Rheinjaeger/CCD/README.md

This is the repository for CCD Small Satellite Readout System Project.
