Rheinjaeger/CCD/Design_Files/CDR(F25-13).pdf

# SwRI CCD Small Satellite Readout System (MDE F25-13)

# Actions

Task Name | Status | Assigned To | Date
Change various “Demonstration” verification types to “Test”. Whatever requires a quantifiable value is a “Test” | Complete | Jae | 4/3/2025
Define the comms protocol we’re using in requirements (from ICD) | Complete | Javier | 4/3/2025
Change “develop” to “utilize” for the comms requirement | Complete | Cody | 4/3/2025
Update Slide 10 to current design (bidirectional communication, etc.) | Complete | Cody | 4/3/2025
Remove anything from the blue box in slide 10 except for the name of our project | Complete | Cody | 4/3/2025

Task Name | Status | Assigned To | Date
Update Concept of Operations: remove shutter | Complete | Yifu | 4/3/2025
Update Concept of Operations: make “start” signal more explicit | Complete | Yifu | 4/3/2025
Update Concept of Operations: remove “image processing” | Complete | Yifu | 4/3/2025
Update Concept of Operations: don’t send signal (it’s requested async). Image is placed in a buffer | Complete | Yifu | 4/3/2025
Remove shutter from subsystem diagram | Complete | Cody | 4/3/2025
Complete Soldering Training and Lab Swipe Access | Complete | Team | 4/3/2025

# Actions

Task Name | Status | Assigned To | Date
CCD Subsystem Diagram: add how the voltage dividers will go high and low using the MOSFETs | Complete | Cody | 4/3/2025
CCD Subsystem Diagram: Complete subsystem layout for CDR | Complete | Cody | 4/3/2025
System Sequencing Diagram: add commands found in ICD | Complete | Javier | 4/3/2025
System Sequencing Diagram: add logic for “idle” and “sleep” functions | Complete | Javier | 4/3/2025
System Sequencing Diagram: change “person” icon to “spacecraft” | Complete | Yifu | 4/3/2025

# Actions

Task Name | Status | Assigned To | Date
Class Diagram: Show parameters for functions | Complete | Javier | 4/3/2025
Class Diagram: remove compression and other unnecessary blocks | Complete | Yifu | 4/3/2025
Class Diagram: expand each box with specifics for CDR | Complete | Javier | 4/3/2025
Class Diagram: change “Data Reorganization” to “Data Storage” | Complete | Yifu | 4/3/2025
Trade Studies: need to be made with later replacing with space-rated parts in mind | Complete | Cody | 4/3/2025

# Actions

Task Name | Status | Assigned To | Date
Cost Table: add estimated PCB costs to the table | Complete | Cody | 4/3/2025
Cost Table: use more of the available $500-750 budget | Complete | Cody | 4/3/2025
System Testing: choose a specific speed to test CCD at to make design easier | Complete | Jae | 4/3/2025
System Testing: no need to test with a light filter, can test with LEDs on a bench | Complete | Jae | 4/3/2025
System Testing: emulator for comms testing needs to be added to the WBS in “Testing Support” | Complete | Javier | 4/3/2025

# Actions

Task Name | Status | Assigned To | Date
System Testing: add TVAC testing to our schedule. Have a bake out schedule | Complete | Team | 4/3/2025
System Testing: make sure we know how to clean our board before entering the TVAC | Complete | Team | 4/3/2025
System Testing: get to know how our specific chamber works (constraints, how to feed wires through). Get an actual tour and as much info as possible on the TVAC chamber | Complete | Team | 4/3/2025
System Testing: add active temp readout through thermistors to the board | Complete | Cody | 4/3/2025

# Actions

Task Name | Status | Assigned To | Date
System Testing: noise testing comes before putting it in the TVAC. Short CCD connections to board ground | Complete | Javier | 4/3/2025
Project Schedule: detailed design needs to be built out for CDR | Complete | Cody | 4/3/2025
Risk Mitigation: need to find a way to mitigate almost certain risks, nothing should be in the red in terms of probability. Re-Assess risks until we have good enough procedures to reduce their probability of occurring | Complete | Jae | 4/3/2025

# Actions

Task Name | Status | Assigned To | Date
Parts Ordering: Start ordering parts that will take long shipping times. | Partially Complete | Team | 4/3/2025
Documents for the customer: Prepare a document that the team and VT isn’t responsible if the CCD is damaged | Partially Complete | Cody | 4/3/2025

# Actions

# WBS

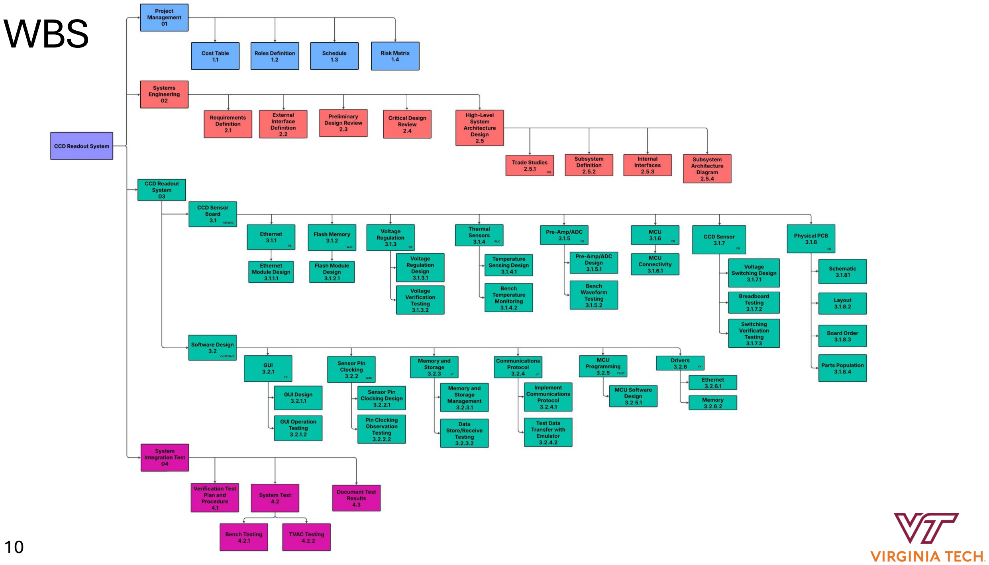
[picture p1: page 10]

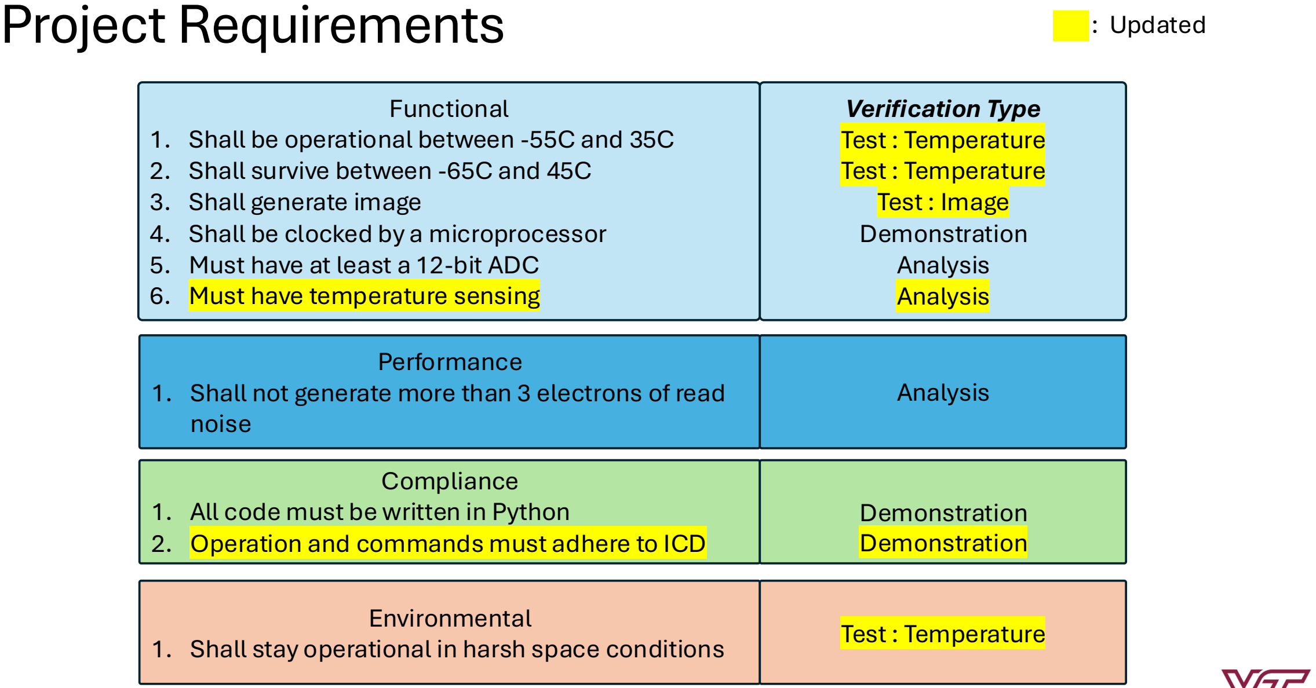
[picture p2: figure]
Project Requirements; Functional; 2. Shall survive between -65C and 45C 3. Shall generate image 4. Shall be clocked by a microprocessor 5. Must have at least a 12-bit ADC 6. Must have temperature sensing; Performance; noise; Compliance 1. All code must be written in Python; Environmental; Verification Type Test : Temperature Test : Temperature Test : Image Demonstration Analysis Analysis; Analysis; Demonstration Demonstration; Test : Temperature; : Updated

1. Shall be operational between -55C and 35C
1. Shall not generate more than 3 electrons of read
2. Operation and commands must adhere to ICD
1. Shall stay operational in harsh space conditions

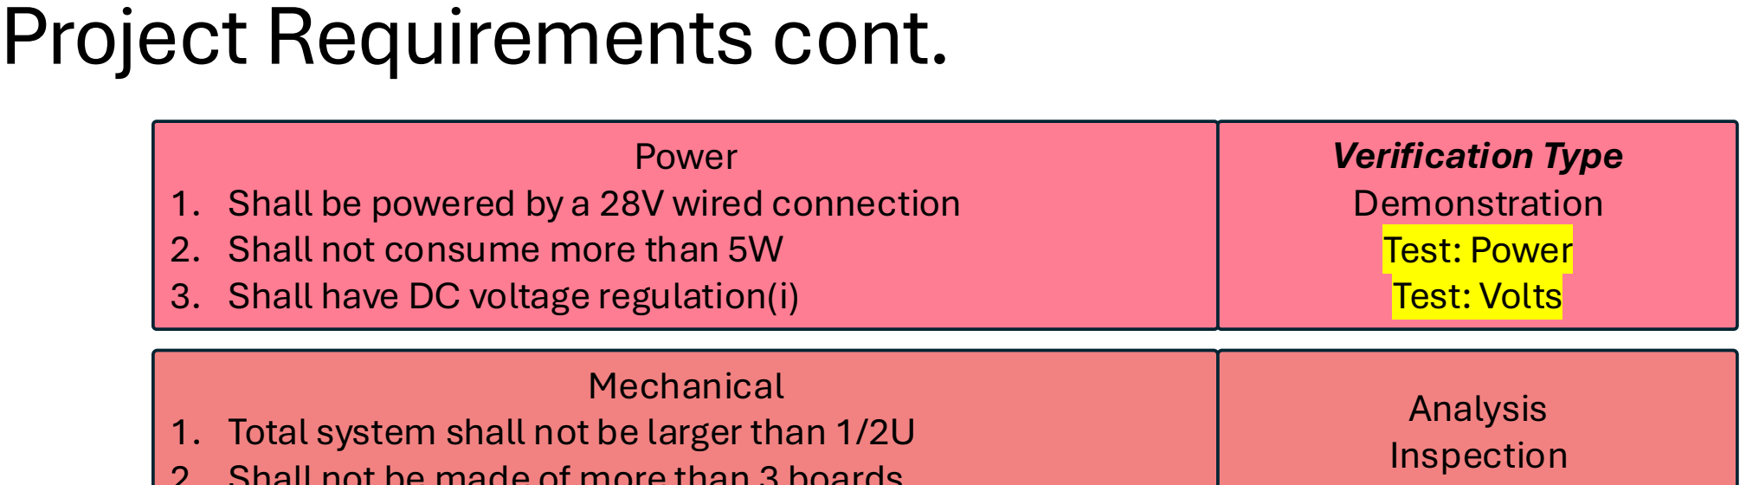
[picture p3: figure]
Power; 2. Shall not consume more than 5W 3. Shall have DC voltage regulation(i); Mechanical; Verification Type Demonstration Test: Power Test: Volts; Analysis Inspection; Project Requirements cont.

1. Shall be powered by a 28V wired connection

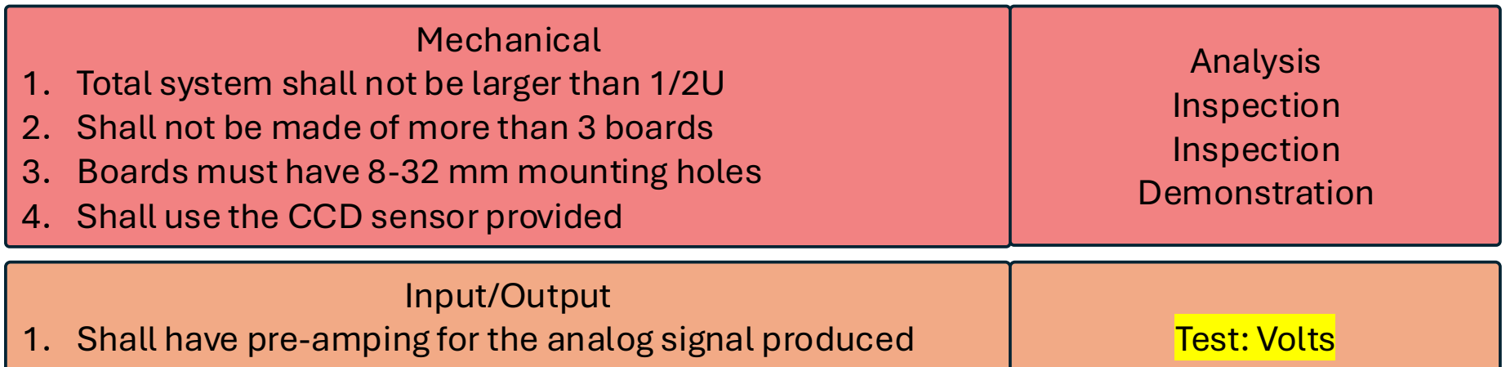
[picture p4: figure]
4. Shall use the CCD sensor provided; Input/Output; Inspection Demonstration; Test: Volts

1. Total system shall not be larger than 1/2U
2. Shall not be made of more than 3 boards
3. Boards must have 8-32 mm mounting holes

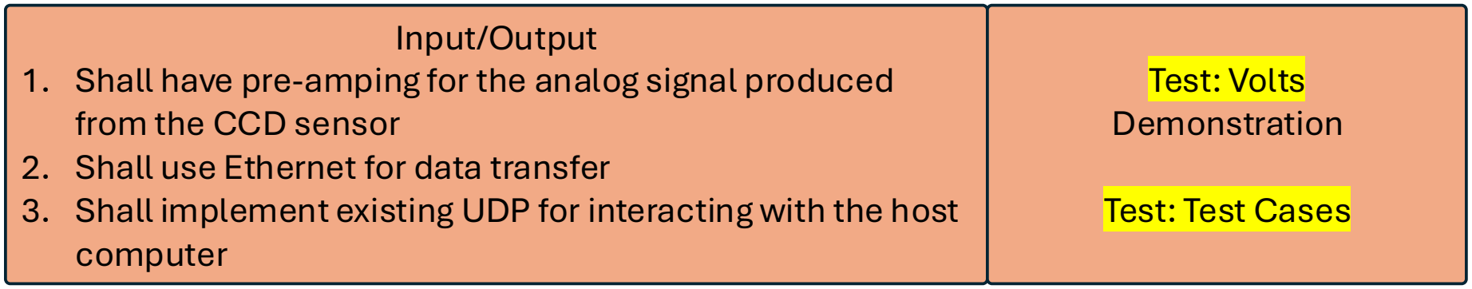
[picture p5: figure]
from the CCD sensor 2. Shall use Ethernet for data transfer; computer; Demonstration; Test: Test Cases

1. Shall have pre-amping for the analog signal produced
3. Shall implement existing UDP for interacting with the host

i: Voltage biasing for 29V, 25V, 17V, 12V, 10V, 9.5 V, 3.3V, 3V

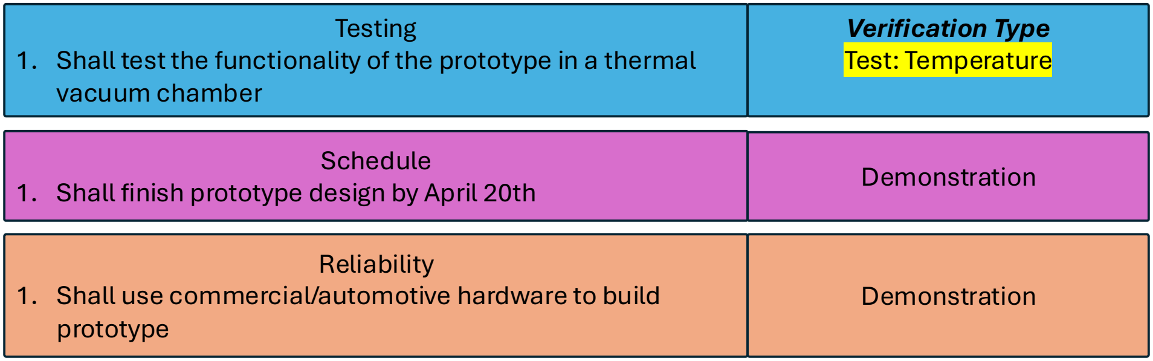
[picture p6: figure]
Testing; vacuum chamber; Schedule; Verification Type Test: Temperature; Demonstration; Reliability; prototype

1. Shall test the functionality of the prototype in a thermal
1. Shall finish prototype design by April 20th

## Nice to Have

1. Should use a 16-bit ADC (as opposed to 12-bit) | Demonstration
1. Shall use commercial/automotive hardware to build

Project Requirements cont.

# CCD Sensor System Diagram

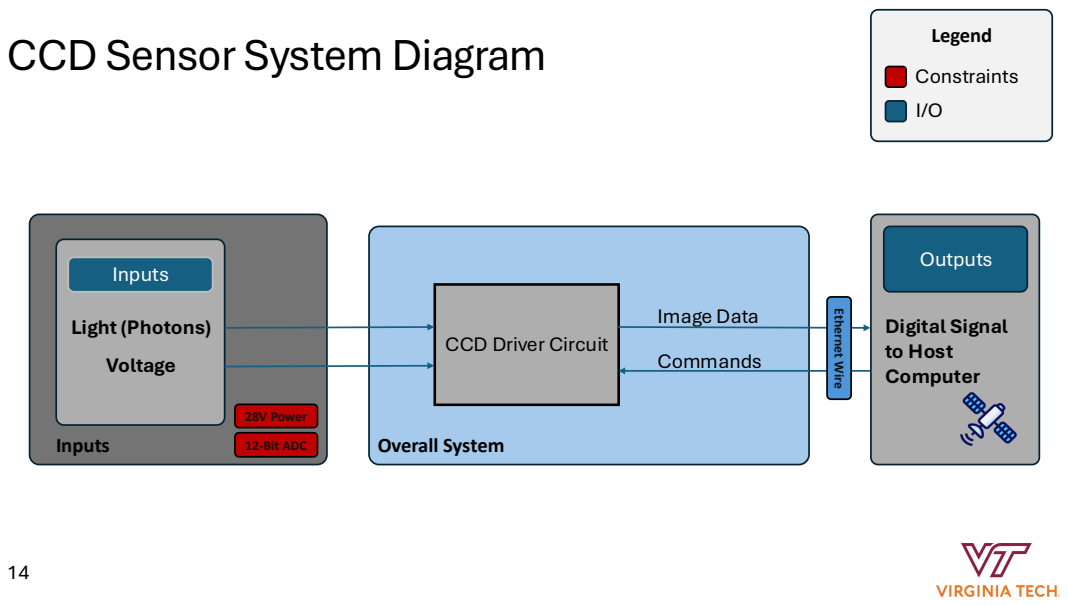
[picture p7: page 14]
Outputs; Digital Signal to Host Computer; Image Data; Overall System; Inputs; Light (Photons); Voltage; 12-Bit ADC; 28V Power; Legend Constraints I/O; Commands; Ethernet Wire

CCD Driver Circuit

# Concepts of Operations

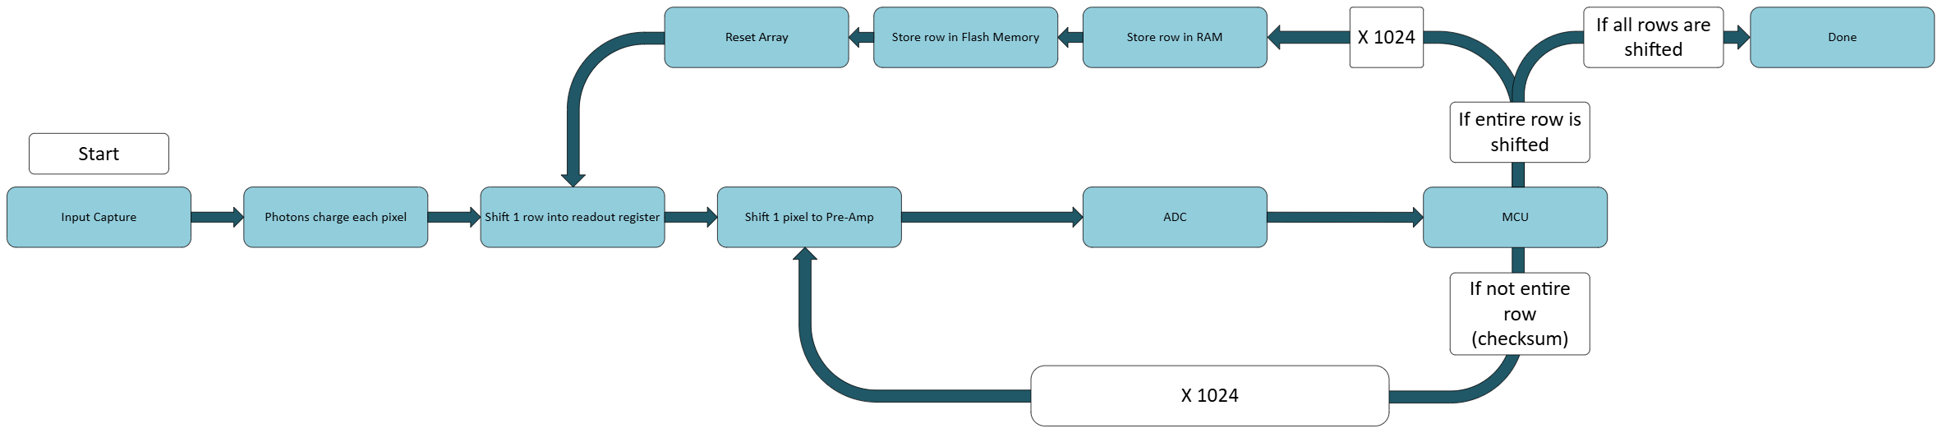
[picture p8: figure]

# Hardware Subsystems

# CCD Subsystem Diagram

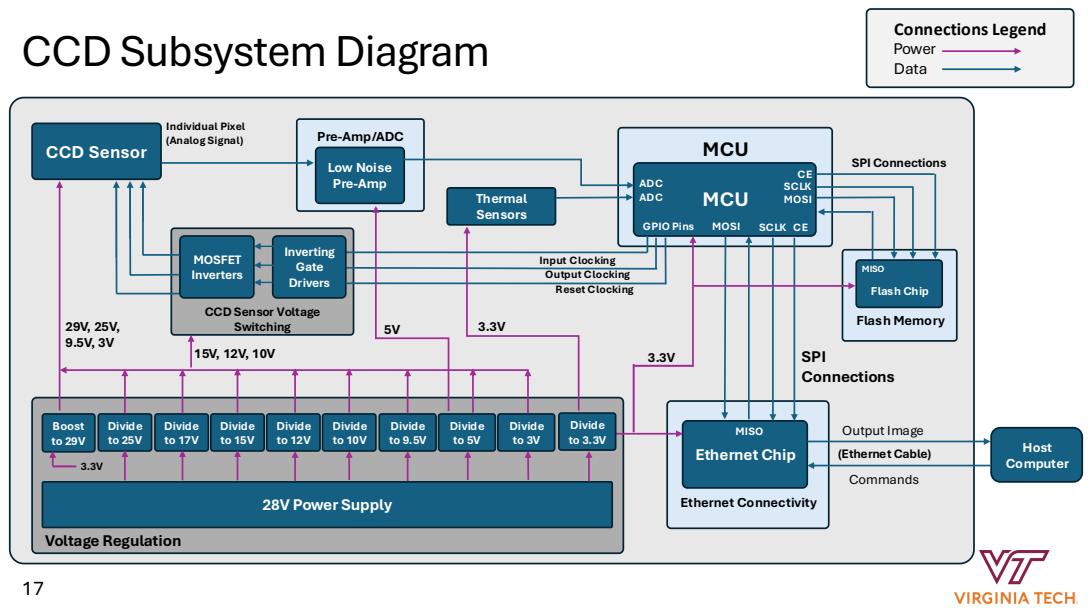
[picture p9: page 17]
Flash Memory; MCU; Flash Chip; CCD Sensor Voltage Switching; Ethernet Connectivity; Ethernet Chip; 28V Power Supply; Divide to 9.5V; Boost to 29V; MISO; Output Image; MOSI; ADC; SCLK CE; Connections Legend Power Data; Host Computer; Divide to 25V; Divide to 17V; Divide to 15V; Divide to 12V; Divide to 10V; Commands; SPI Connections; GPIO Pins; Input Clocking Output Clocking Reset Clocking; Individual Pixel (Analog Signal); (Ethernet Cable); MOSFET Inverters; CE SCLK MOSI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

Pre-Amp/ADC
Low Noise
Pre-Amp

# PCB Schematics and Simulations

# PCB Schematic: MCU, Preamp, and Memory

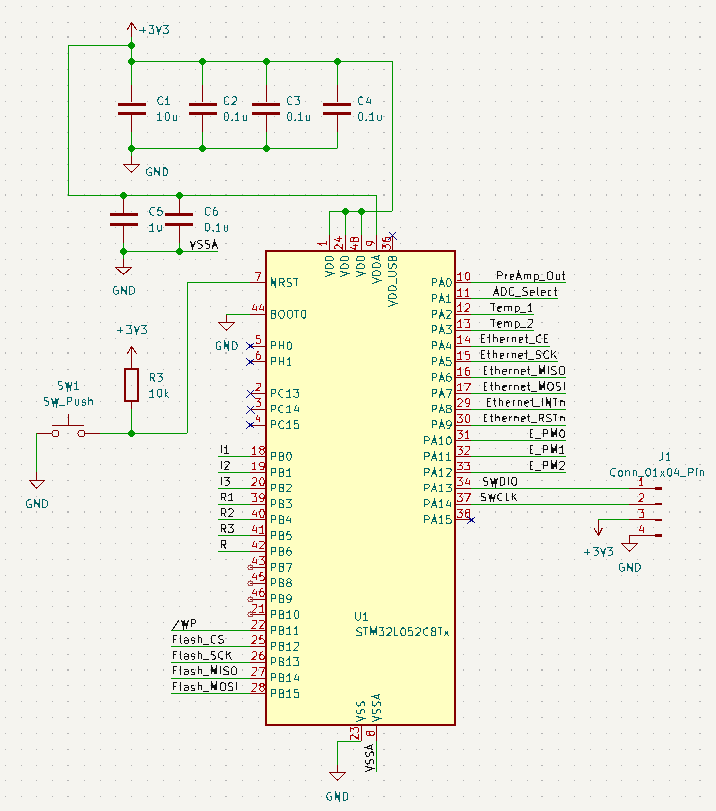
[picture p10: figure]

Labeled Connections to:
- Pre-Amp
- Temperature Sensors 1 and 2
- Ethernet Module (W5500)
- SWD Debug Pins
- Flash Memory Chip
- Gate Driver Inputs

Other Connections:
- VDD and decoupling capacitors
- Push Button with a Pull-Up Resistor for Reset
- Boot0 pulled low for normal booting

# PCB Schematic: Preamp and Flash Memory

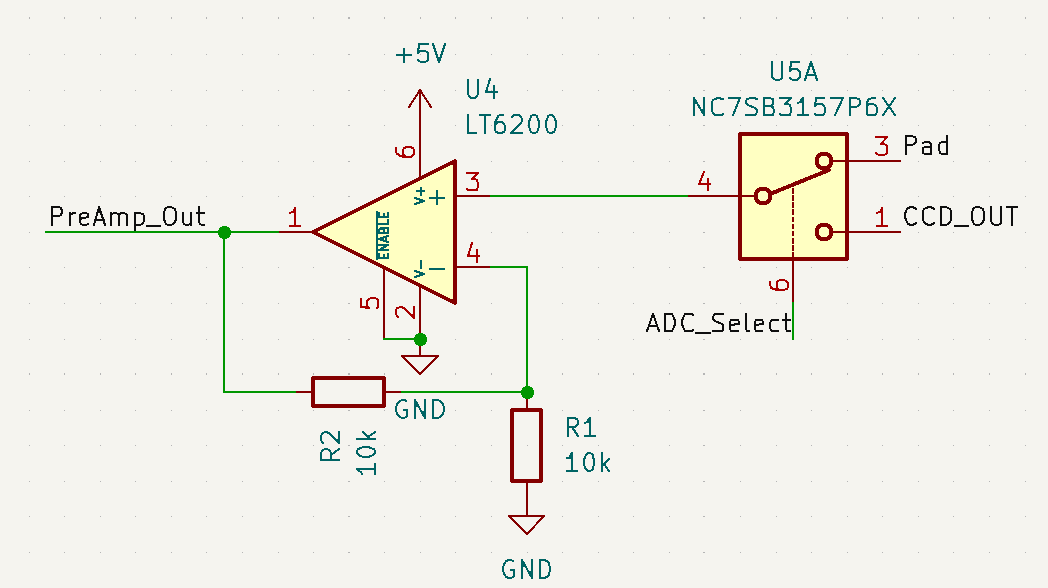
[picture p11: figure]

- Amplifier with a Gain of 2
- Positive input is connected to a 2x1 MUX, which is connected to a pad, and the CCD output
- The select pin for the MUX is connected to a GPIO pin on the MCU

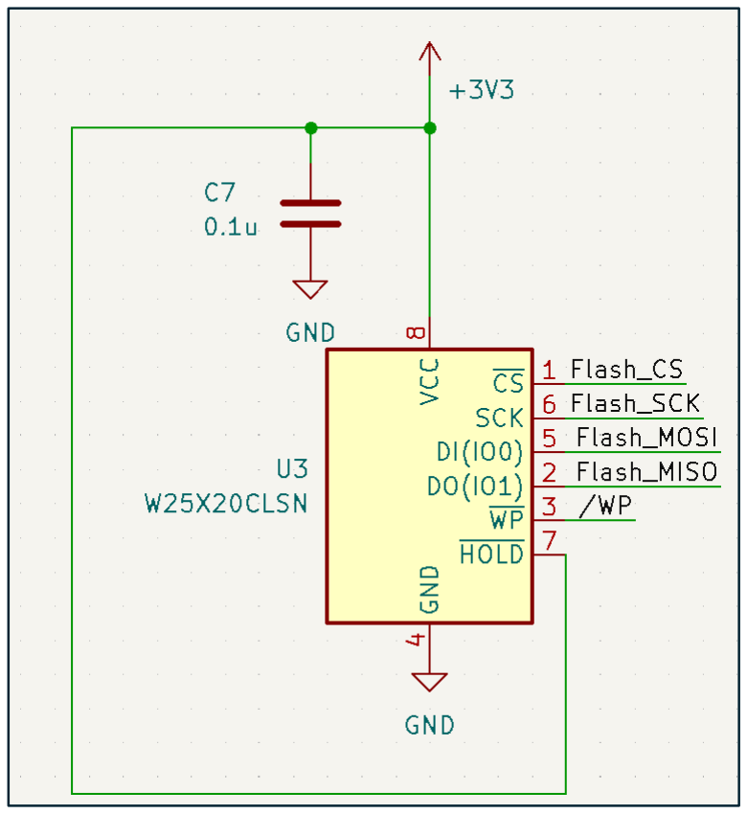
[picture p12: figure]

- 1Gbit Flash Memory
- Pins connected to the second SPI channel on the MCU

# PCB Schematic: Power Regulation (Voltage Dividers)

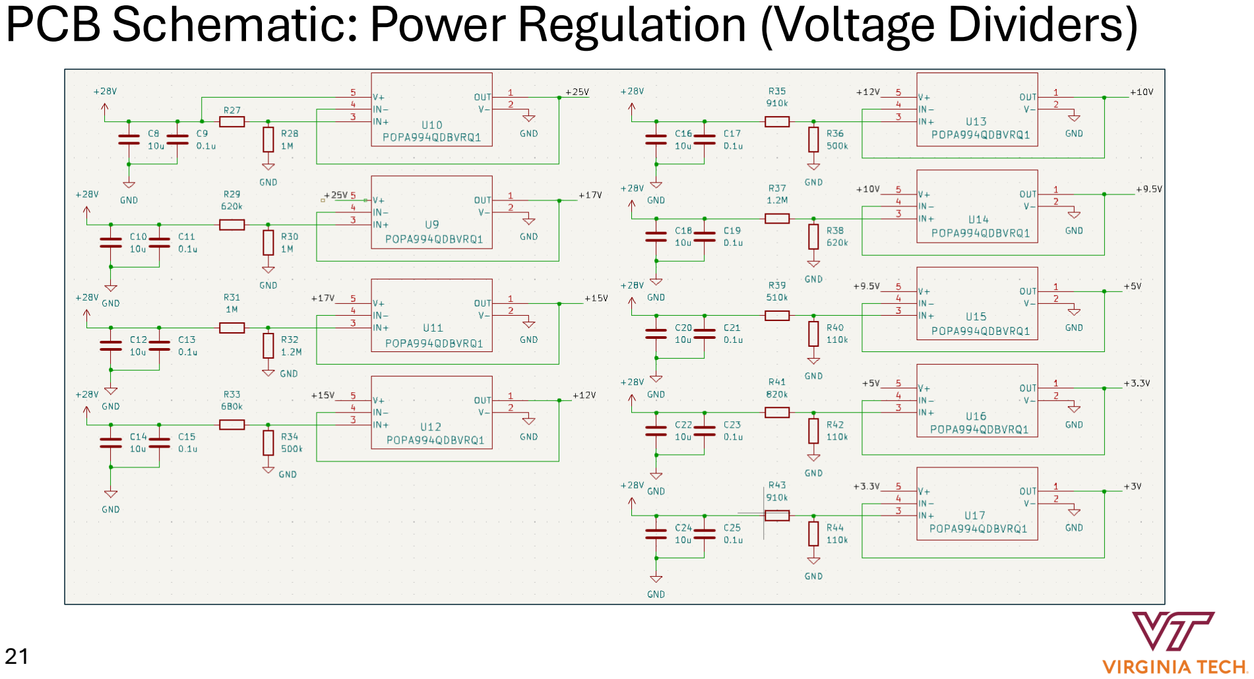
[picture p13: page 21]

# Hardware Simulation: Voltage Dividers

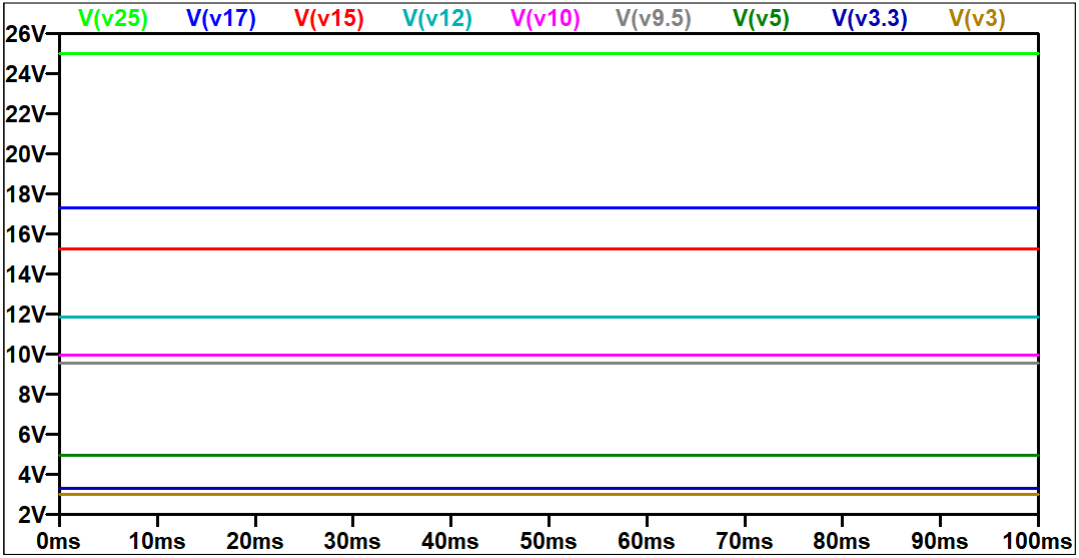
[picture p14: figure]

# PCB Schematic: Power Regulation (Boost Converter)

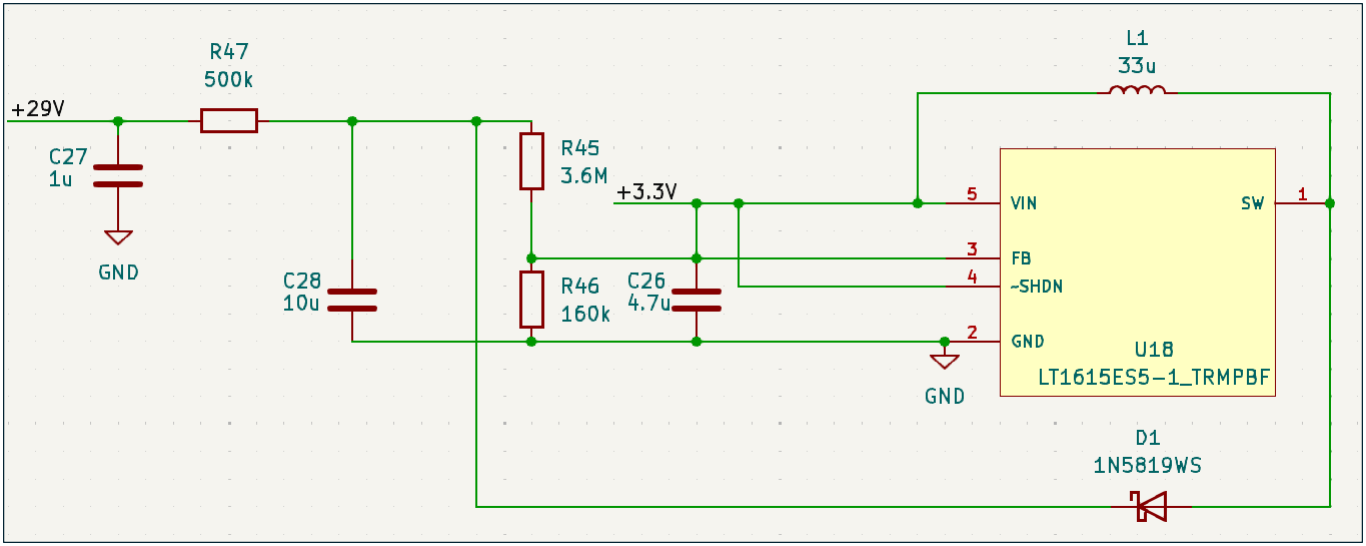
[picture p15: figure]

# Hardware Simulation: Boost Converter to 29V

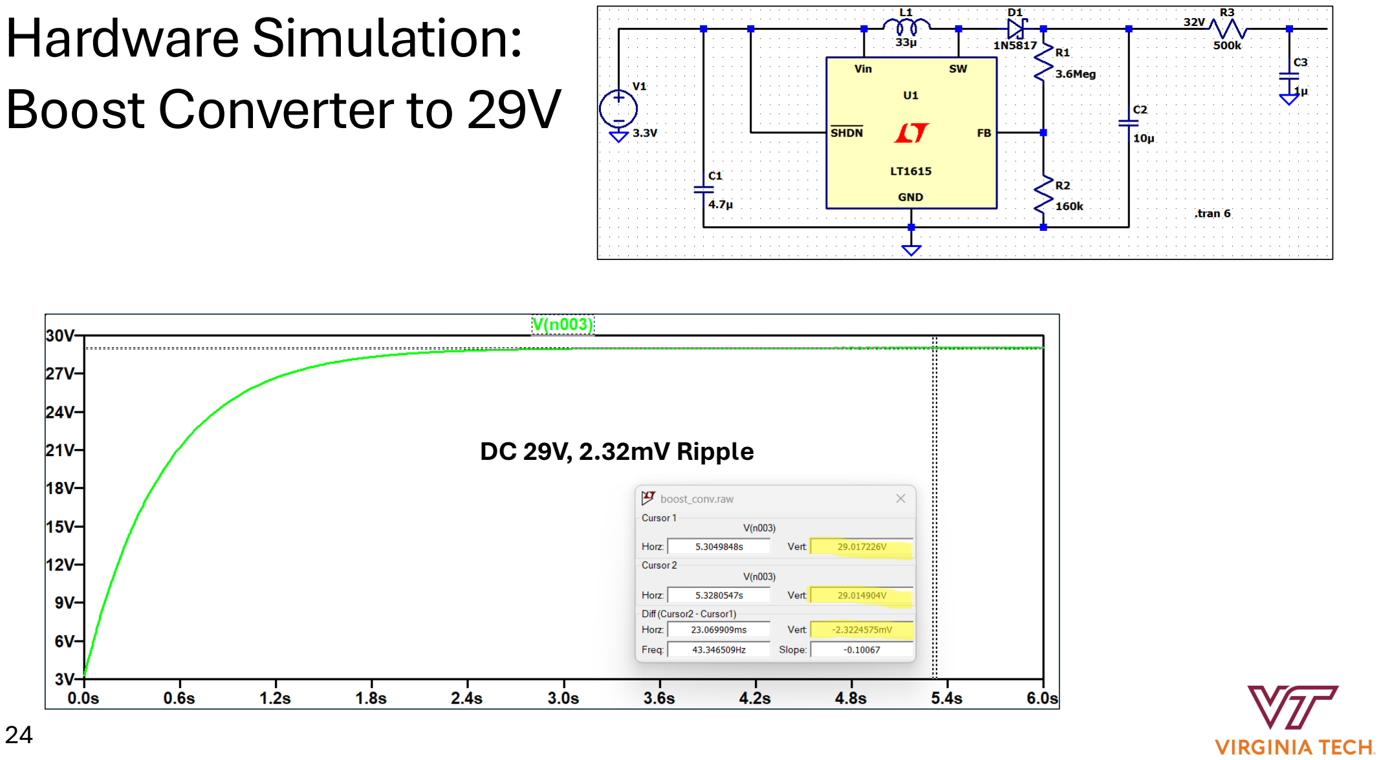
[picture p16: page 24]

DC 29V, 2.32mV Ripple

# PCB Schematic: MOSFET Switching (One Switch)

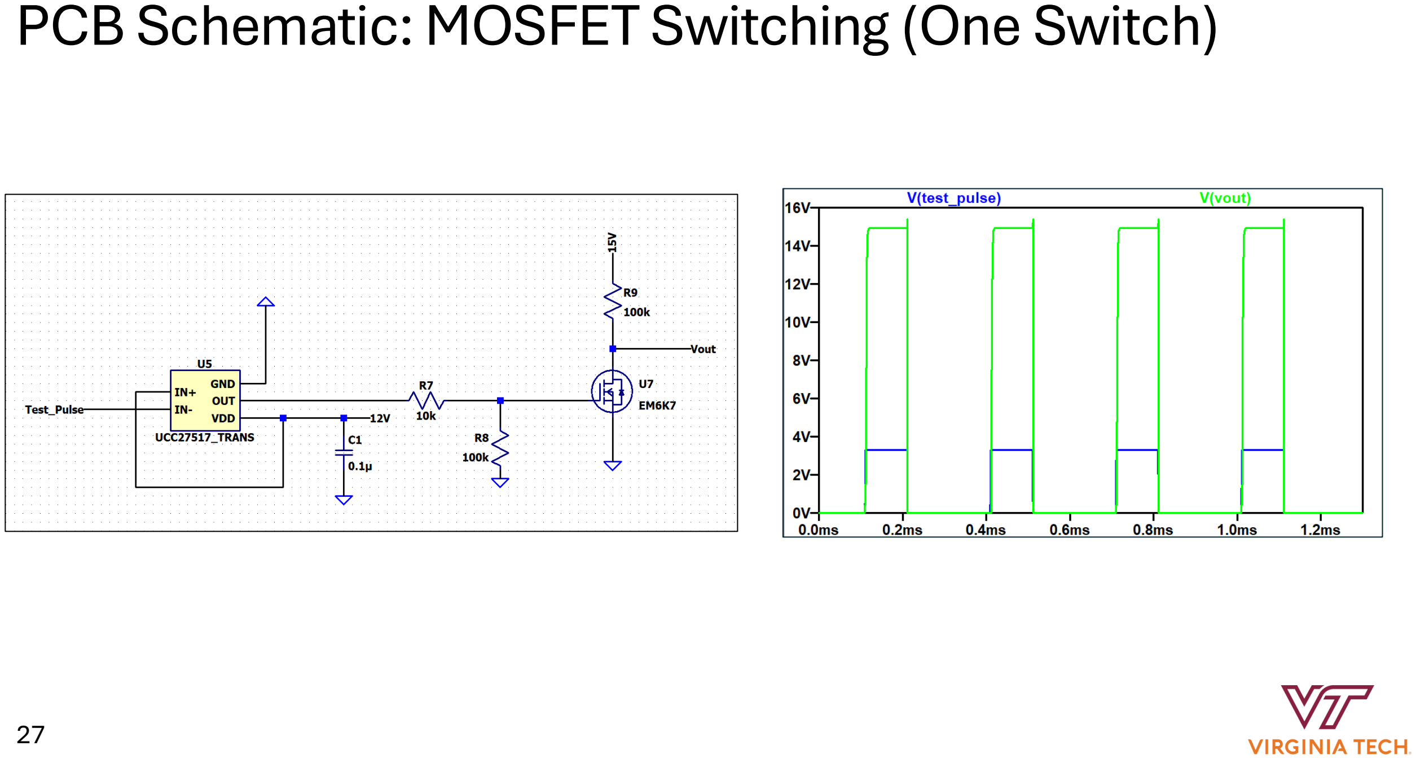
[picture p17: page 25]

# PCB Schematic: MOSFET Switching (Section 1)

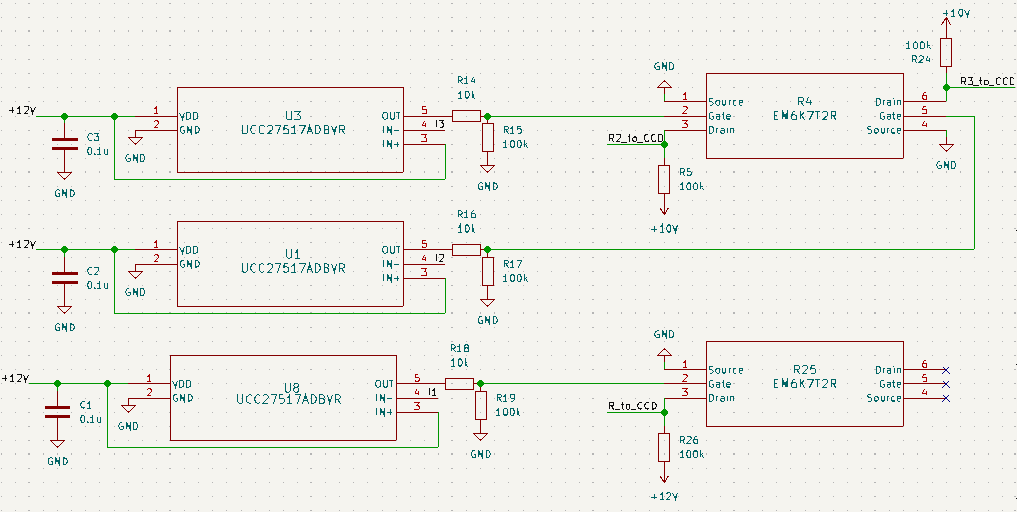
[picture p18: figure]

# PCB Schematic: MOSFET Switching (Section 2)

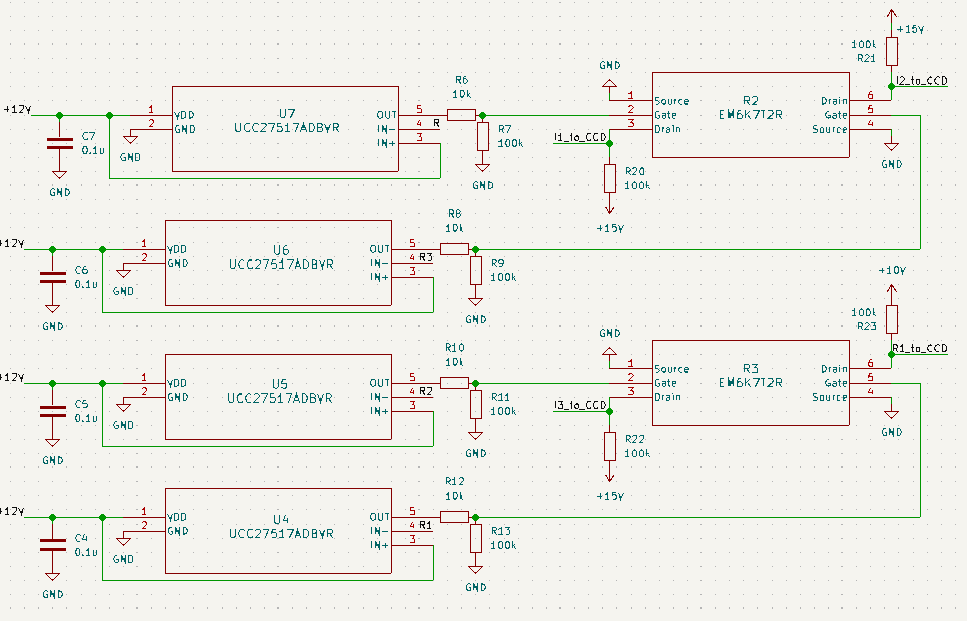
[picture p19: figure]

# PCB Schematic: Ethernet Module

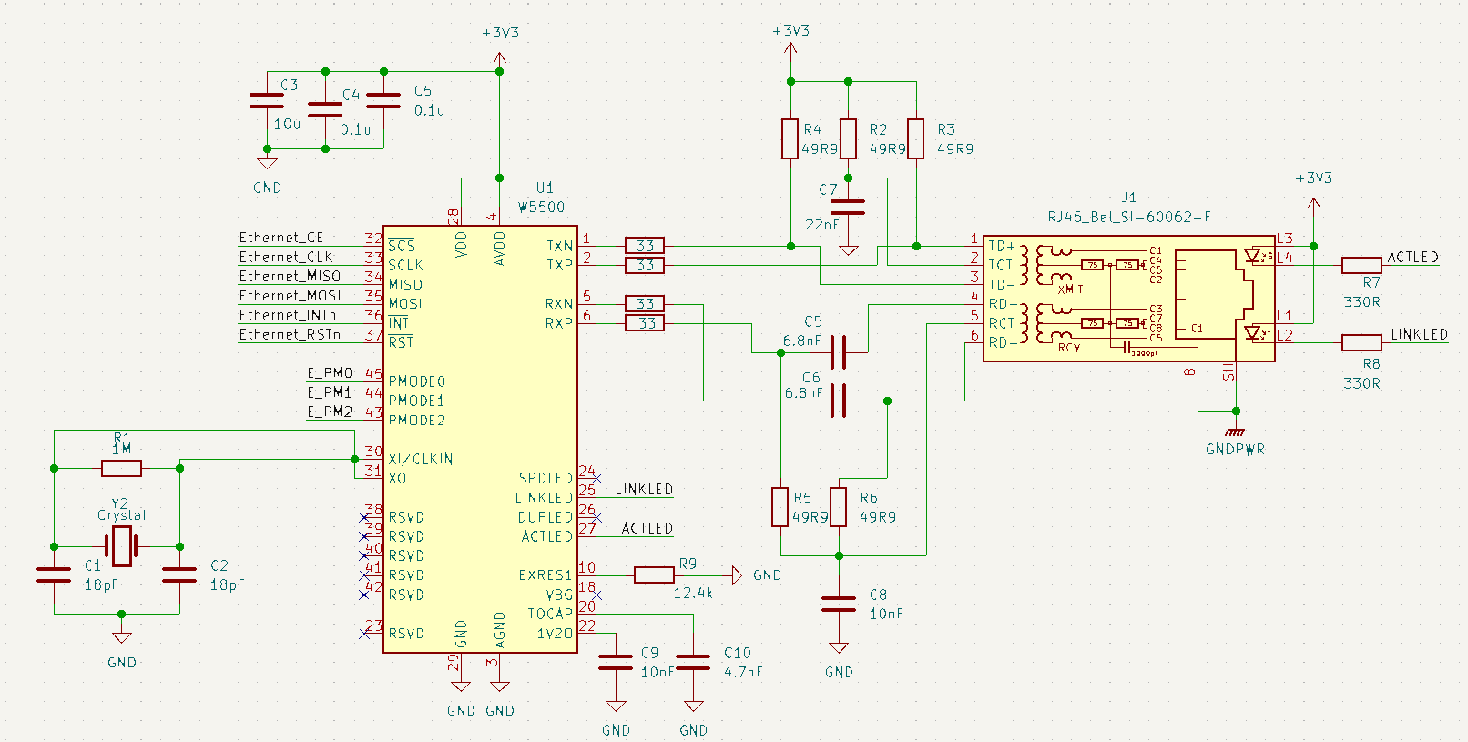
[picture p20: figure]

Connections to MCU
are labeled on the left
side

The RJ45 connector has
integrated magnetics

The crystal oscillator in
the bottom left is
25MHz

# PCB Schematic: CCD Sensor

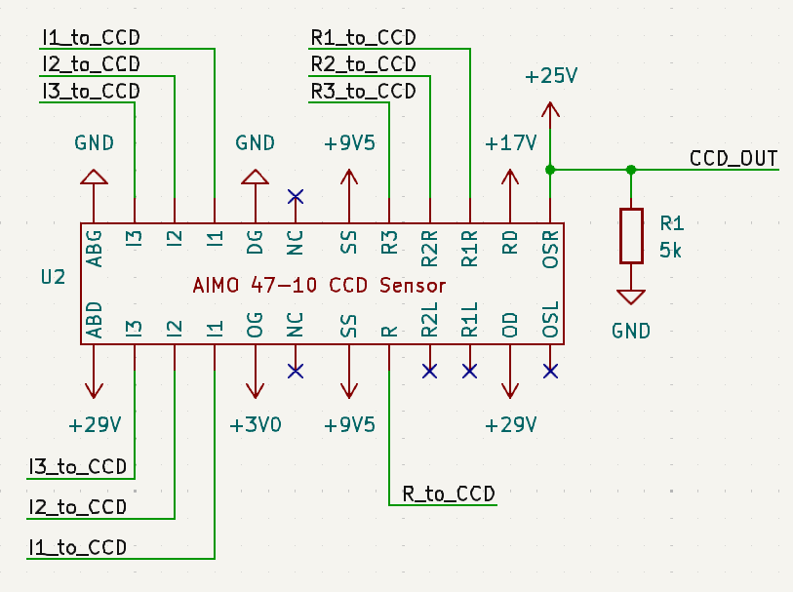
[picture p21: figure]

Signal names come from switching outputs created on slides 23 and 24, and from the MCU schematic on slide 18

Voltage values come from the voltage regulation outputs from slides 19 and 21

# PCB Schematic: Thermal Sensors

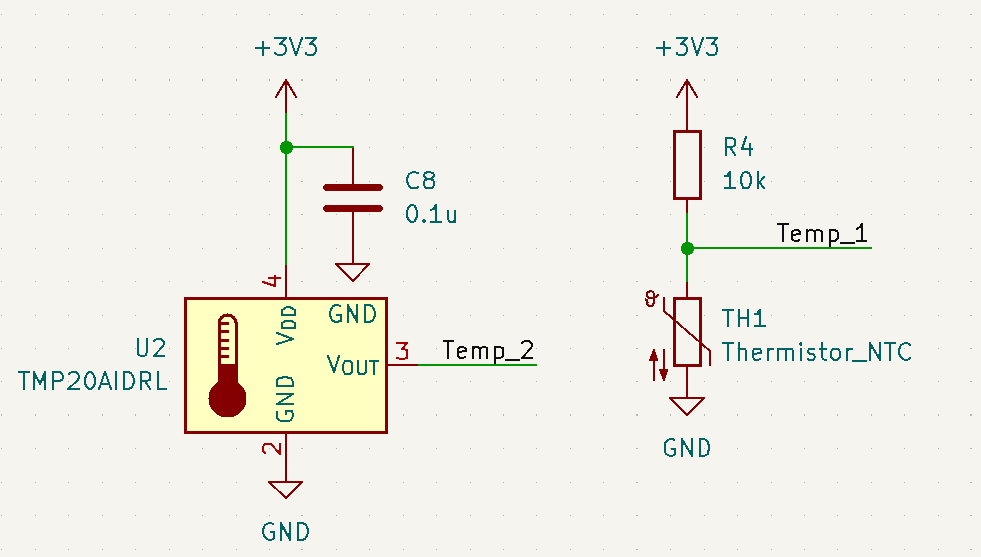
[picture p22: figure]

Temp_1: Environment Temperature Measurement with Thermistor

Temp_2: Board Temperature
Measurement with SMD Component

Item | Purpose | Quantity | Unit Price | Total Price
STM32L073CZT6 | MCU | 1 | $5.03 | $5.03
LT6200 | Low-Noise ADC Preamplifier | 1 | $6.33 | $6.33
W5500 Chip | Used to transmit data from the MCU through SPI to an ethernet cable | 1 | $4.99 | $4.99
EM6K7 | MOSFETS used for voltage switches | 4 | $0.58 | $2.32
UCC27517 | MOSFET Gate Drivers | 7 | $1.16 | $8.12
TMP20AIDRLR | SMD Temperature Sensor | 1 | $0.97 | $0.97
OPA2994 | 36V Rail-to-Rail Op-Amps | 9 | $2.35 | $21.15
W25N01GVZEIG | 1 Gbit Flash Memory | 1 | $3.10 | $3.10
PCBs | Physical PCBs | 5 | ~$8 | ~$40
LT1615 | Boost Converter Switch | 1 | $7.40 | $7.40
RJ45 Connector | Ethernet connector with integrated magnetics | 1 | $7.15 | $7.15
| | Total | | $101.57

# Cost Table

# Software Subsystems

# Subsystem Overview

## - GUI

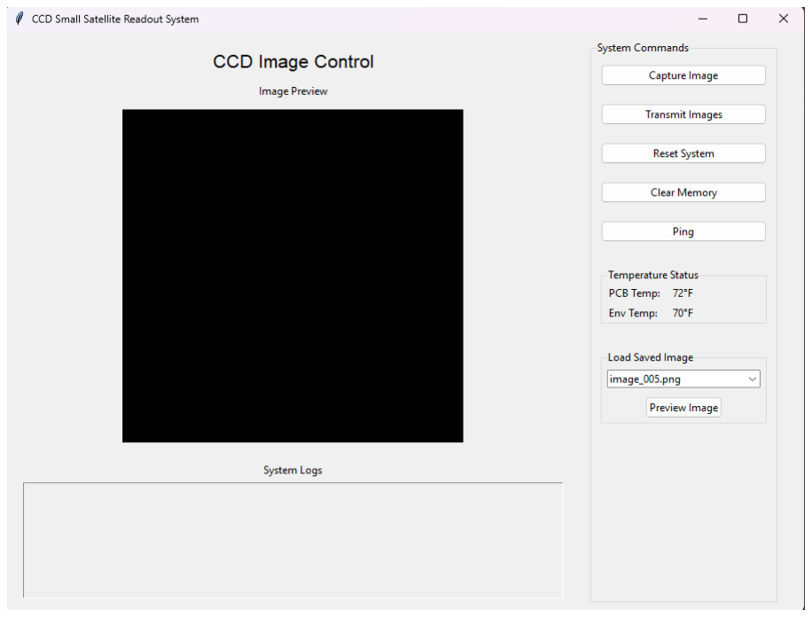
[picture p23: figure]

- Emulation of satellite
interaction with the
CCD

## - Ethernet

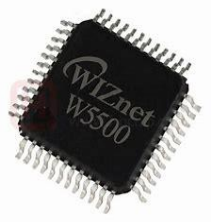
[picture p24: figure]

- Mode of
communication and
data transfer
- W5500 Ethernet
Chip with RJ45

## - MCU

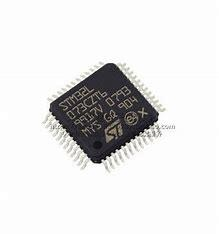
[picture p25: figure]

- Microcontroller using
Micro python to
facilitate protocol
- STM32L073CZT6

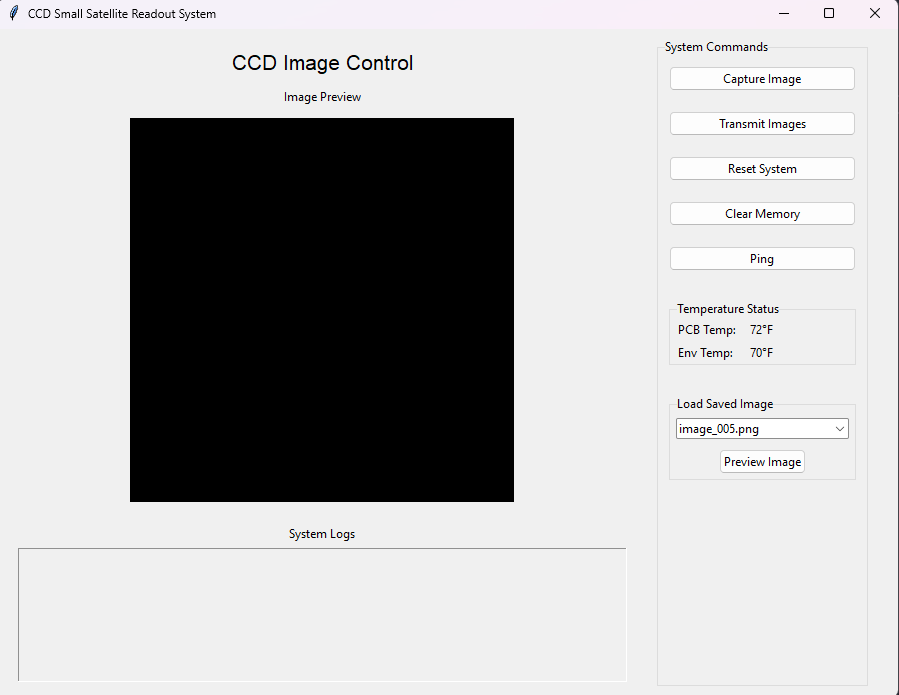
[picture p26: figure]

# GUI functionality

## - Image portrayal

- Section where greyscale
image is shown

## - Command Buttons

- Buttons used for sending commands

## - Logging Interface

- Feedback logging and
system state logging

## - Temperature Readout

- Constantly reads out PCB temperature
and environment
temperature

# Self-Imposed Commands

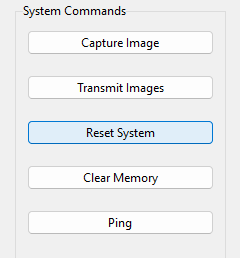
[picture p27: figure]

## - Capture Image

- Store image data and headers from ccd
sensor into external flash memory

## - Transmit Image(s)

- Transmits images stored in external flash memory through ethernet bus

## - Reset System

- Clears memory, resets system to initial state

## - Clear Memory

- Clears Flash memory without resetting full system

## - Ping

- Tests if PCB is alive and connected through ethernet

# Command Packet Format

Command ID

Reserved

## - Command ID (1 byte)

- Capture Image = 0x01
- Transmit Images = 0x02
- Reset System = 0x03
- Clear Memory = 0x04
- Ping = 0x05

## - Reserved (7 bytes)

- Set to 8 bytes for future integration and consistency

# Logging Packet Format

Message Type

Reserved

## - Message Type (1 byte)

- Info = 0x10
- Warning = 0x11
- Error = 0x12
- PCB Temperature = 0x13
- Environment Temperature = 0x14

## - Reserved (1 byte) - Length (1 byte)

- Length of text in bytes

## - ASCII Text (n bytes)

Length | ASCII Text

# Image Data Packet Format

## - Packet Type (1 byte)

- Image transfer = 0x20

## - Image ID (4 bytes)

- This lets satellite know which image this chunk belongs to

## - Chunk Offset (4 bytes)

- Indicates the byte position in the image that the chunk starts from

## - Payload Length (n bytes)

- Total Length of payload

## - Checksum (4 bytes) - Image data (n bytes)

Packet Type | Image ID | Chunk Offset | Payload Length | Checksum | Image Data

# Data Formats

Image ID | Image Size
Checksum | Reserved | Pixel Data

## - Metadata (16 bytes)

- Image ID
- Image Size (Bytes)
- Checksum
- Reserved

## - Pixel format

- 16-bit pixel (2 bytes)
- 4 LSB's are Zero Padded

XXXXXXXXXXXX0000

# Software Subsystem Sequencing Diagram

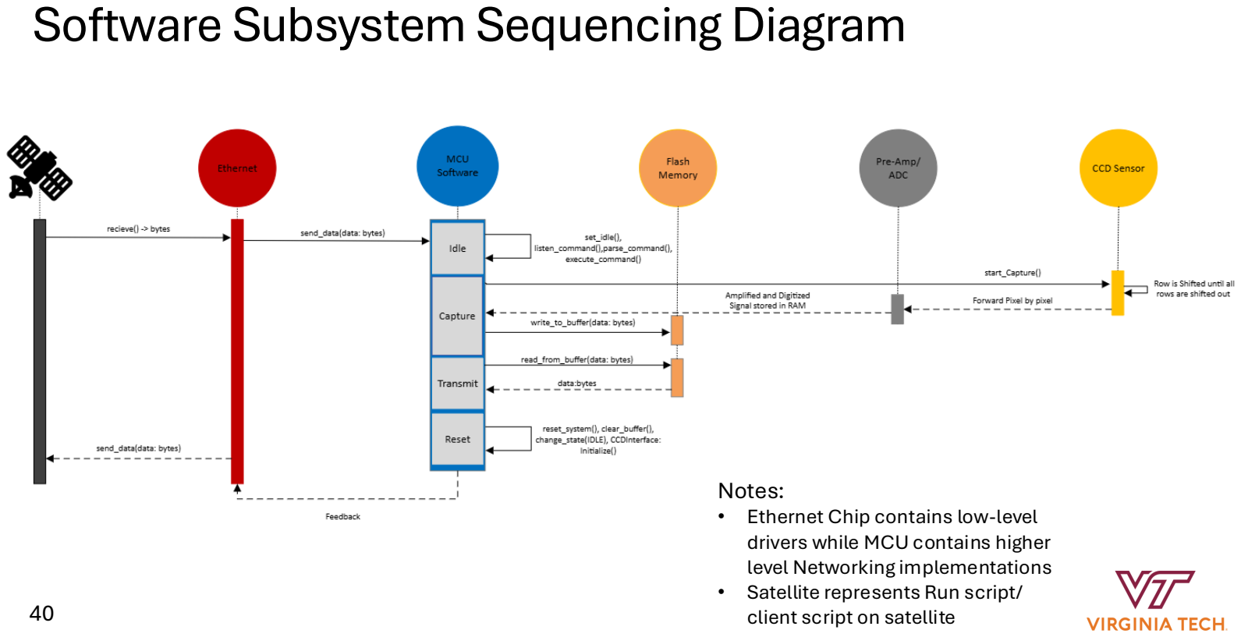
[picture p28: page 40]

Notes:
- Ethernet Chip contains low-level drivers while MCU contains higher level Networking implementations
- Satellite represents Run script/ client script on satellite

# Software Class Diagram

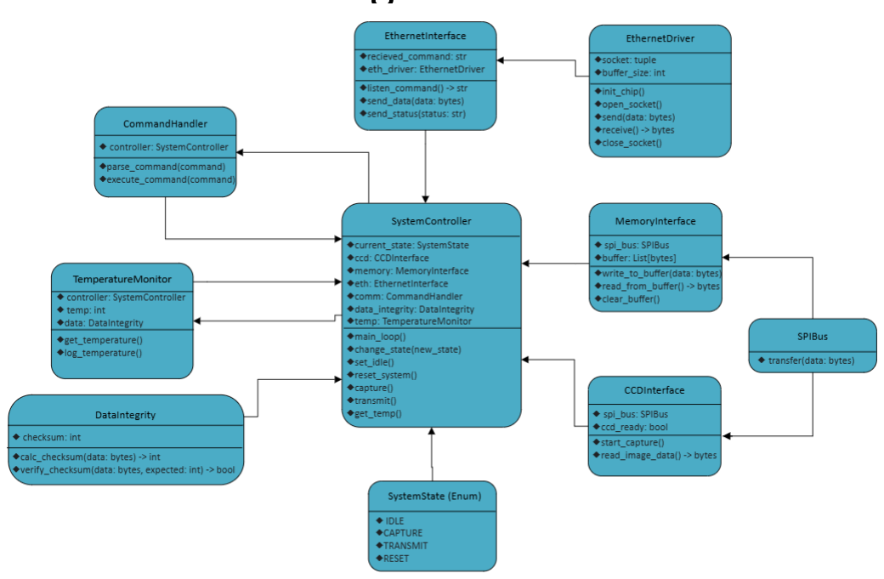
[picture p29: figure]

Notes:
- Modular Design
- System Controller
class main software
interface
- Low level
Ethernet firmware
lives on ethernet chip
while TCP/IP stack or
higher-level
networking firmware
exists on MCU

# ICD Adhering

To Be Provided:
- Run Script
- Bash Script that runs instance of camera module
- Can be executed in BASH terminal or Systemd service
- Disk cleanup script
- Bash Script that manages cleaning up image files on local Pleiades storage
- Systemd file
- Used by Systemd for running the camera instance as a Linux service
- Currently running on Ubuntu 22.04
- Update crontab to perform disk cleanup
- Task scheduling for the disk cleanup script need to be updated using crontab
- Images are saved to local storage as uncompressed Portable Network Graphics

./CCD_Run –m $mac_address –o $output_path

# Subsystem Testing

# Voltage Verification Testing

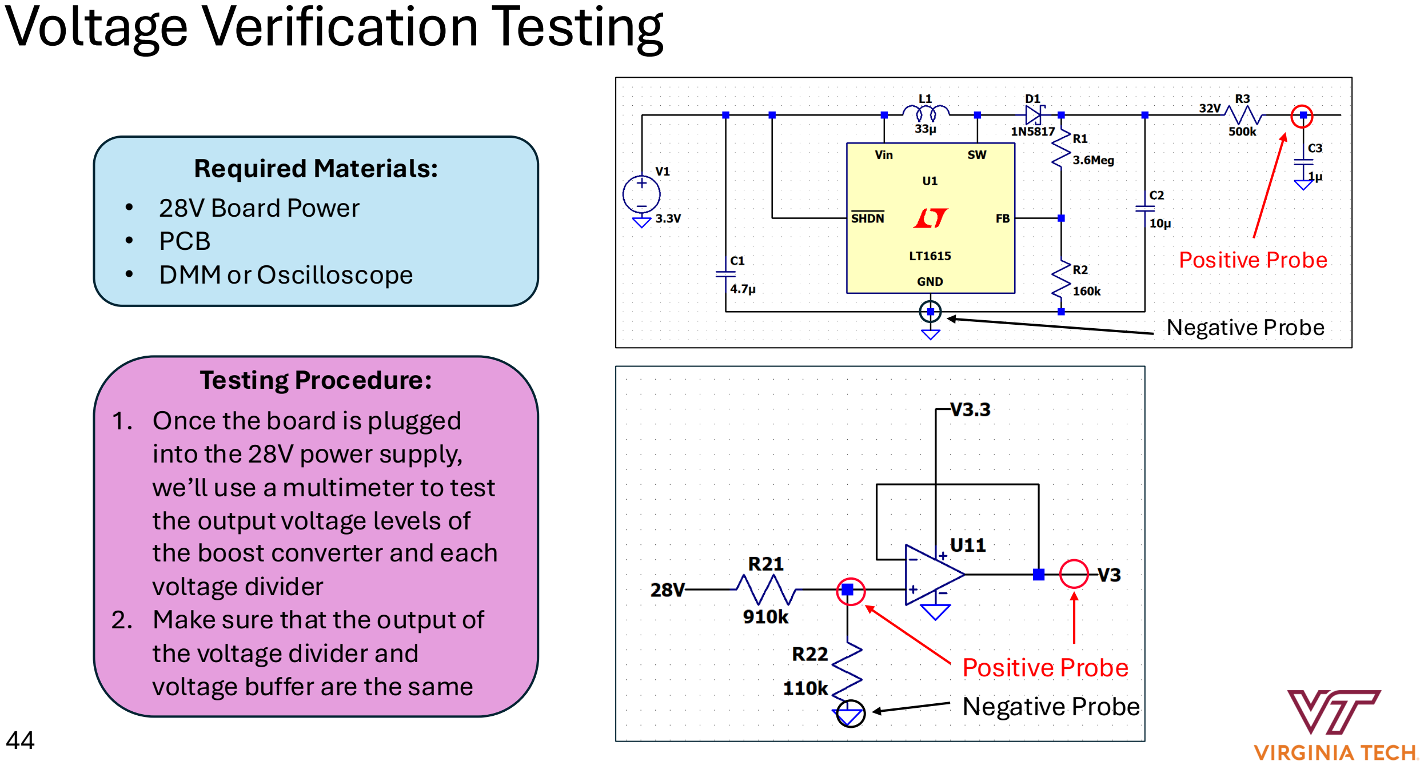
[picture p30: page 44]

Required Materials:
- 28V Board Power
- PCB
- DMM or Oscilloscope

Testing Procedure:
1. Once the board is plugged into the 28V power supply, we’ll use a multimeter to test the output voltage levels of the boost converter and each voltage divider
2. Make sure that the output of the voltage divider and
voltage buffer are the same

Positive Probe
Negative Probe

Positive Probe

Negative Probe

# Bench Waveform Testing

Required Materials:
- 28V Board Power
- PCB
- Function/Wave Generator
- Laptop to Program/Debug MCU
- IDE for Programming/Console Output

Testing Procedure:
1. Apply voltage through
function generator
2. Signal goes through MUX, to Pre-Amp, to ADC
3. Digital signal is printed to the console

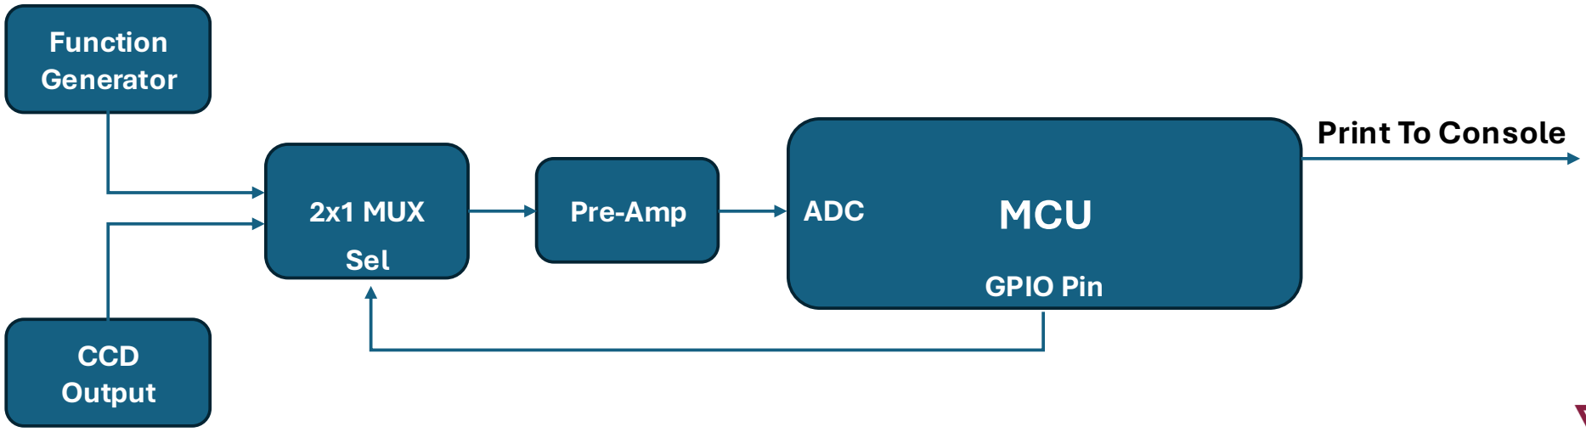
[picture p31: figure]
Pre-Amp; Function Generator; ADC; MCU; GPIO Pin; 2x1 MUX Sel; CCD Output; Print To Console

# Switching Verification and Pin Observation Testing

Required Materials:
- 28V Board Power

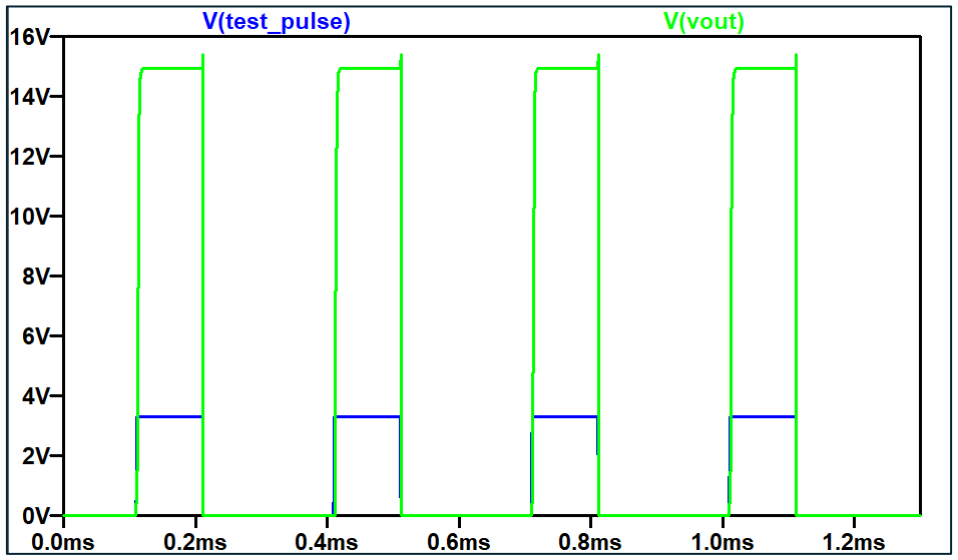
[picture p32: figure]

- PCB
- Oscilloscope
- Software to control the timing outputs for the CCD sensor

Testing Procedure:
1. Flash the development board with the software to control the timing outputs

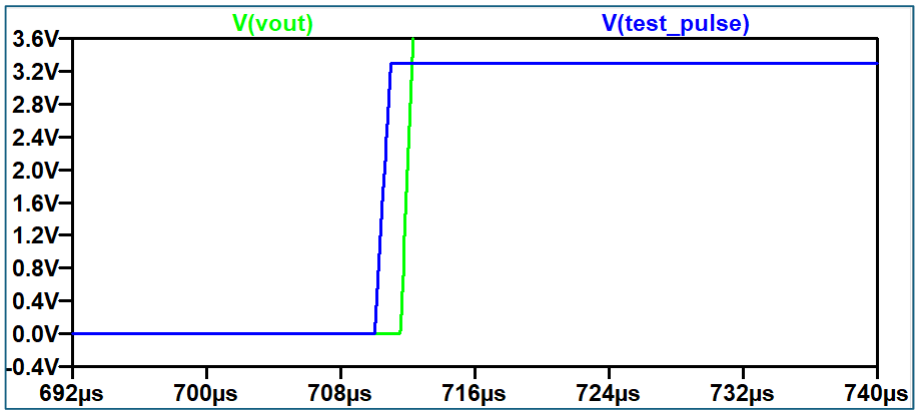
[picture p33: figure]

for the CCD sensor
2. With the oscilloscope, probe the input pins of the CCD sensor.
3. Run the program and see if the timing diagrams for the pin matches up with the planned-out timing scheme

# Bench Temperature Monitoring

Required Materials:

- 28V Board Power

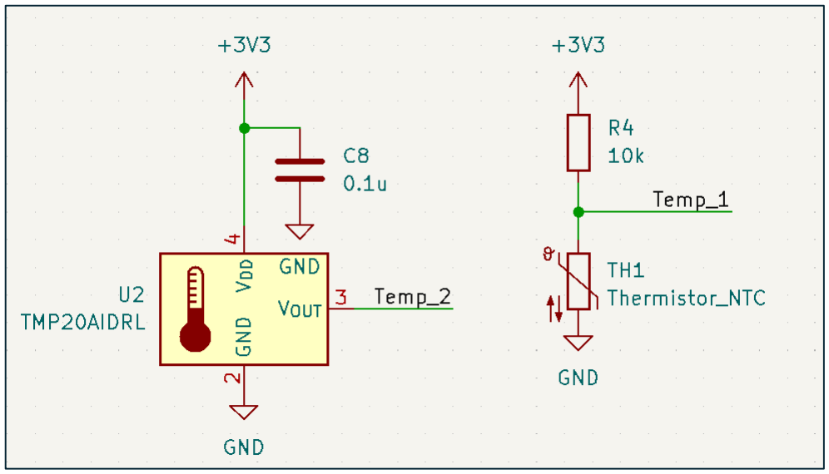
[picture p34: figure]

- PCB
- Laptop to Program/Debug MCU
- IDE for Programming/Console Output
- Thermometer

Testing Procedure
1. Read the temperature sensor

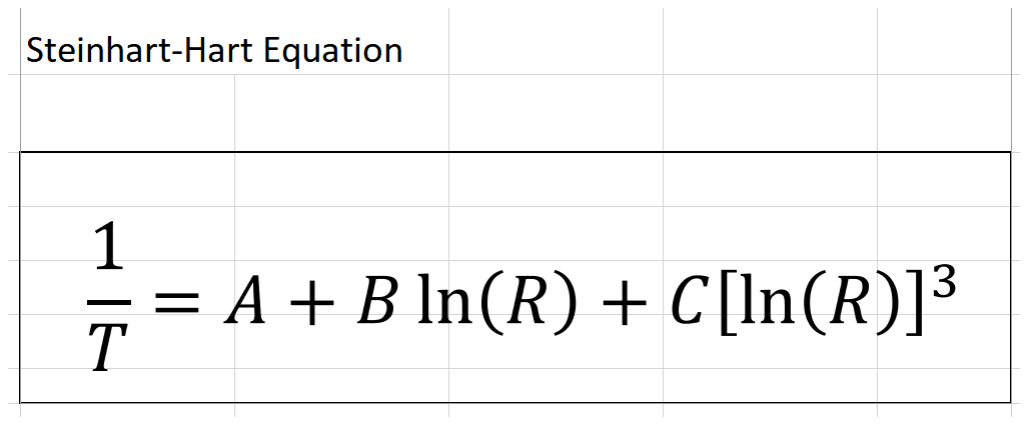
[picture p35: figure]

voltages through the MCU’s ADC
2. Convert those voltages to temperatures in Celsius using the Steinhart-Hart equation
3. Compare to the thermometer’s room reading

# Data Store/Receive Testing

Required Materials:
- 28V Board Power
- PCB
- IDE for Programming/Console Output

Testing Procedure:
1. Send data from the MCU through SPI to the flash chip
2. Retrieve the sent data from the flash module and print to console to verify it’s unchanged

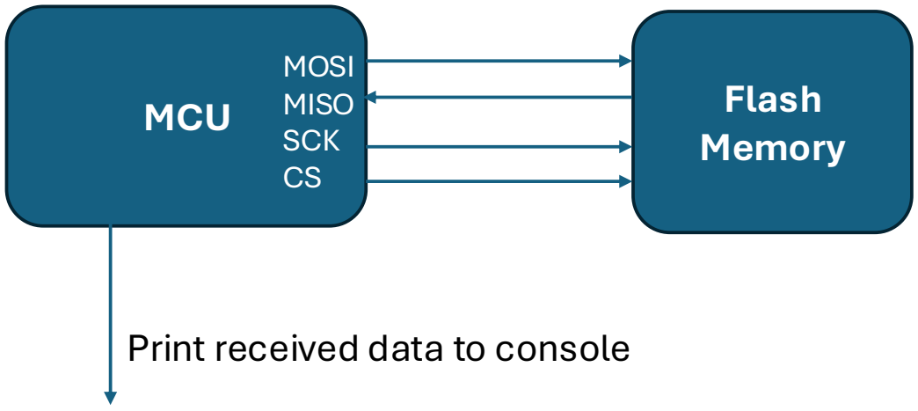
[picture p36: figure]
MCU; Flash; Memory; MOSI MISO SCK CS; Print received data to console

# Testing Data Transfer and GUI Operations

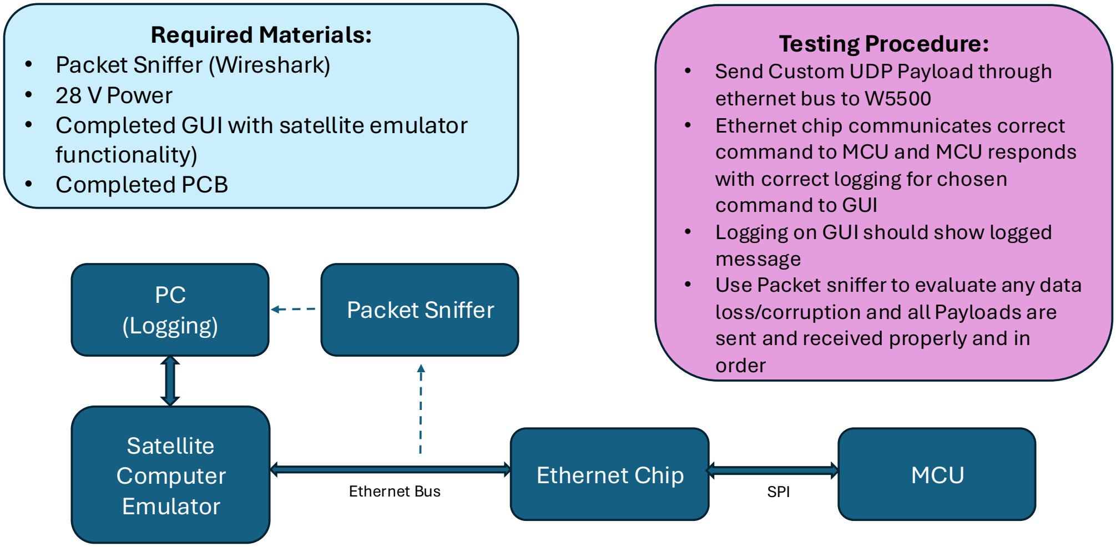
[picture p37: figure]
Satellite Computer Emulator; (Logging); Packet Sniffer; Ethernet Chip; Ethernet Bus; MCU; SPI; Required Materials: • Packet Sniffer (Wireshark) • 28 V Power • Completed GUI with satellite emulator functionality) • Completed PCB; Testing Procedure: • Send Custom UDP Payload through ethernet bus to W5500 • Ethernet chip communicates correct command to MCU and MCU responds with correct logging for chosen command to GUI • Logging on GUI should show logged message; loss/corruption and all Payloads are sent and received properly and in order

- Use Packet sniffer to evaluate any data

# System Testing

# Noise Level Testing Diagram

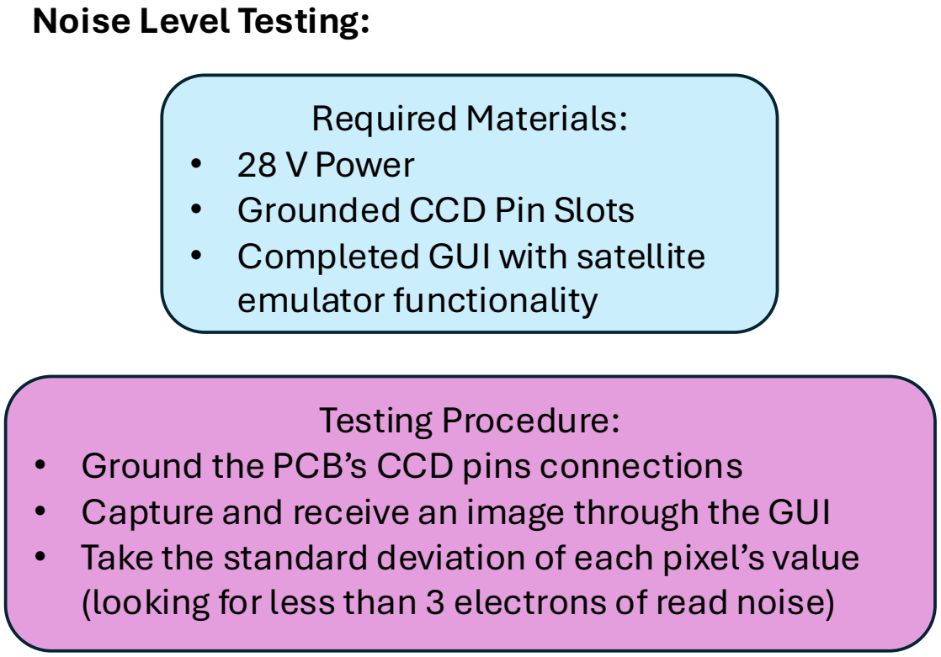
[picture p38: figure]
Noise Level Testing:; Required Materials: • 28 V Power • Grounded CCD Pin Slots • Completed GUI with satellite emulator functionality; Testing Procedure: • Ground the PCB’s CCD pins connections

- Capture and receive an image through the GUI
- Take the standard deviation of each pixel’s value (looking for less than 3 electrons of read noise)

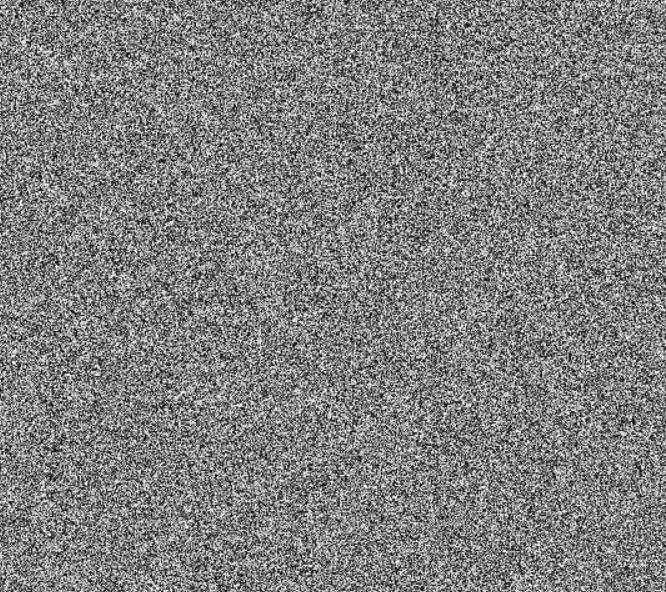
[picture p39: figure]

Grounded Image Sample

Required Materials:
- LED
- 28V Board Power
- PCB
- Laptop
- IDE for Programming and
- Ethernet Cable
- Completed GUI with satellite emulator functionality

# Bench Testing

Testing Procedure:
- Turn on the LED in front of the CCD sensor
- Press “Take Image” on GUI
- Validate if the voltage levels are as expected through the IDE console
- Press “Receive Image/Buffer” on GUI
- Validate the accuracy of the image posted in the GUI

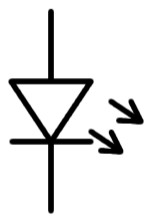
[picture p40: figure]
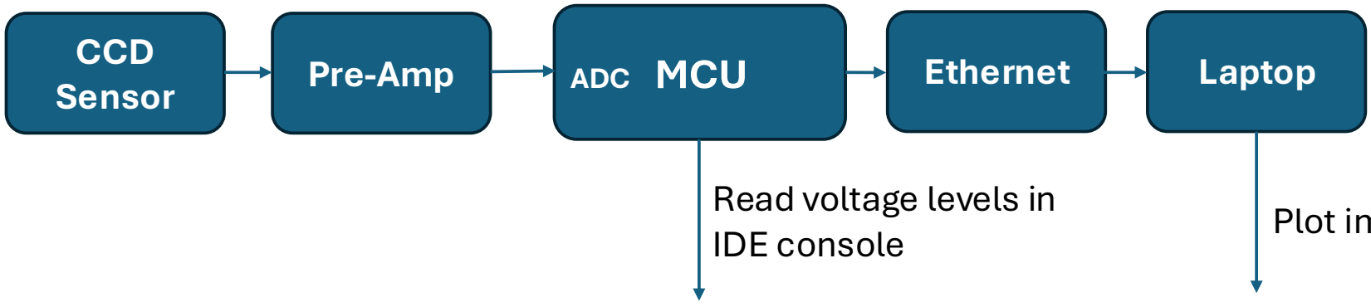
[picture p41: figure]
ADC MCU; CCD; Sensor; Pre-Amp; Ethernet; Laptop; IDE console

Plot image data in GUI Read voltage levels in

# TVAC Testing

Testing Procedure:
- Bakeout PCB
- Operate vacuum within
operating temperatures (-40C to 85C)
- Test taking images inside the TVAC chamber
- Read temperature from both sensors

Required Materials:
- PCB
- Thermal Vacuum Chamber
- 28V Power
- Ethernet Cable
- Completed GUI with satellite emulator functionality

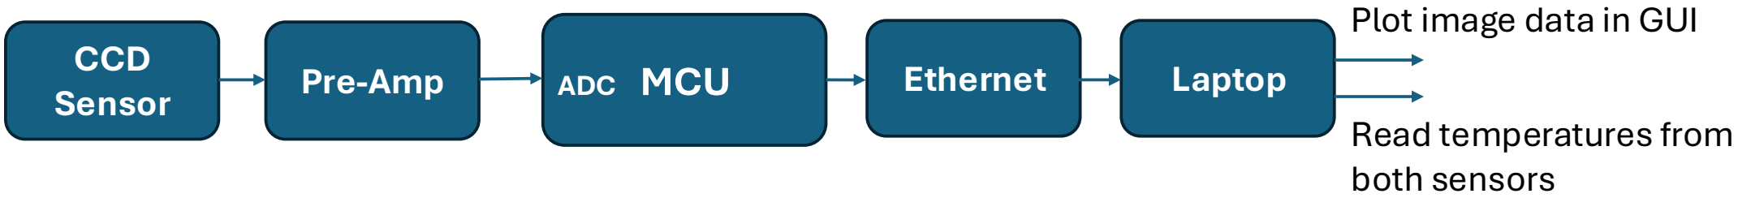
[picture p42: figure]
ADC MCU CCD; Sensor; Pre-Amp; Ethernet; Laptop; Plot image data in GUI; Read temperatures from both sensors

# Thermal Vacuum Chamber

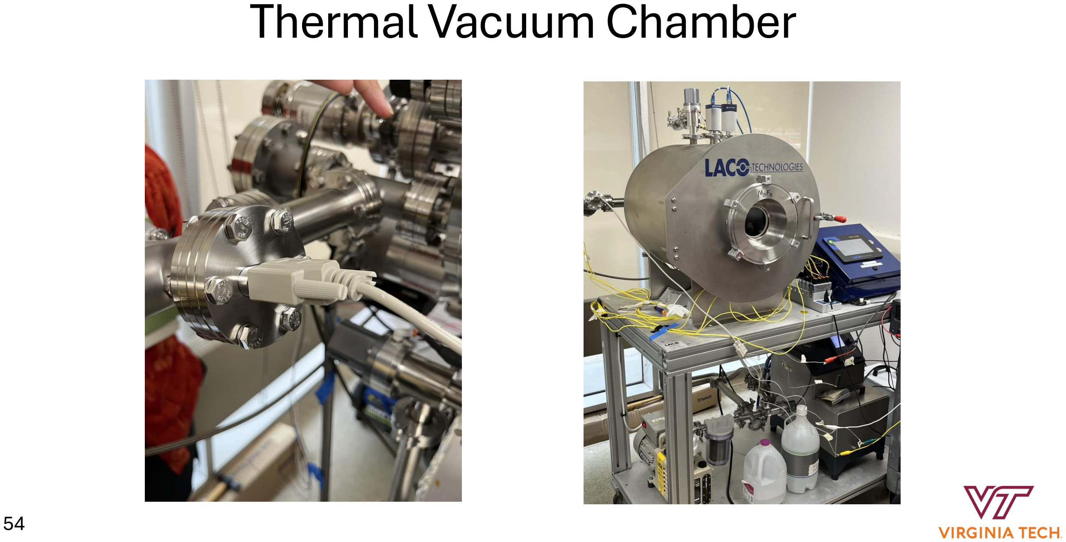
[picture p43: page 54]

# Project Schedule and Risks

# Updated Project Schedule

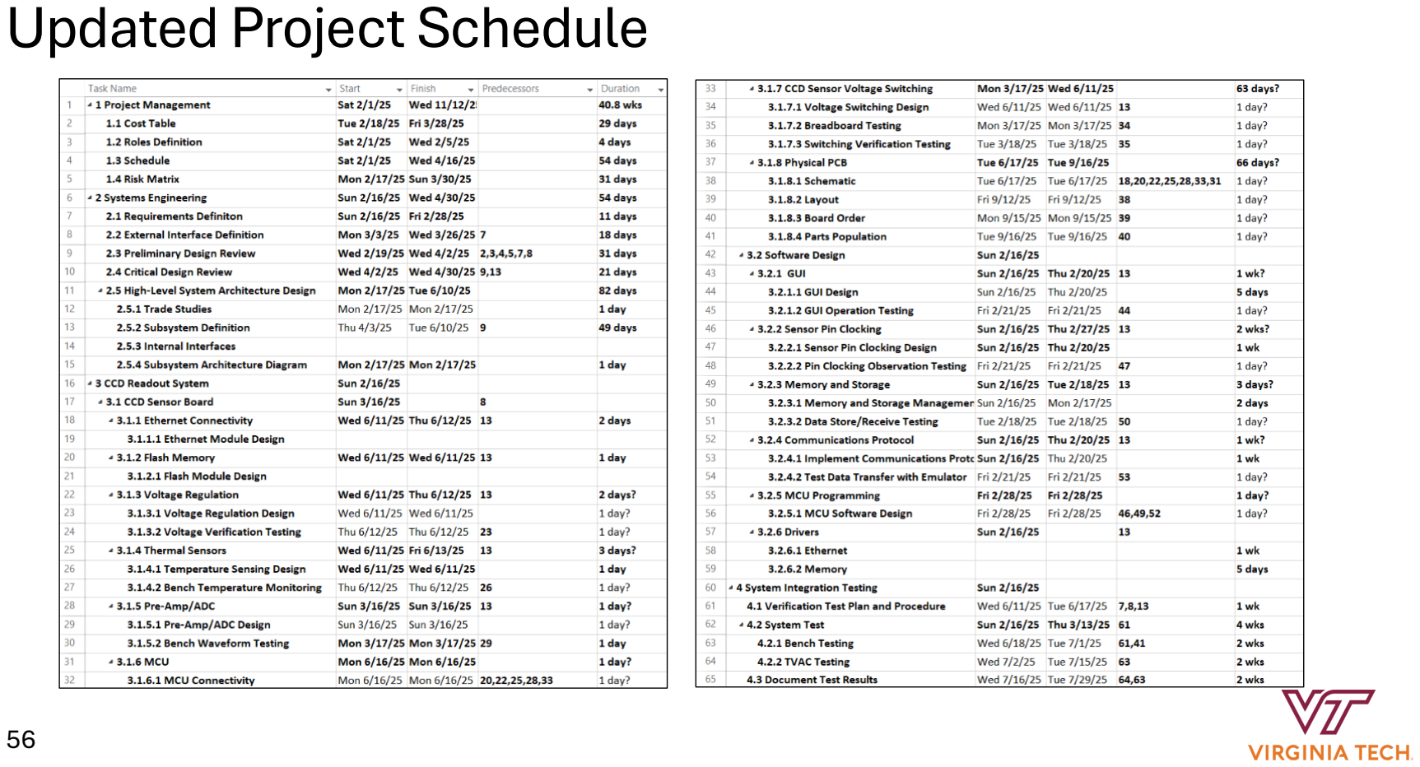
[picture p44: page 56]

# Sprint Board

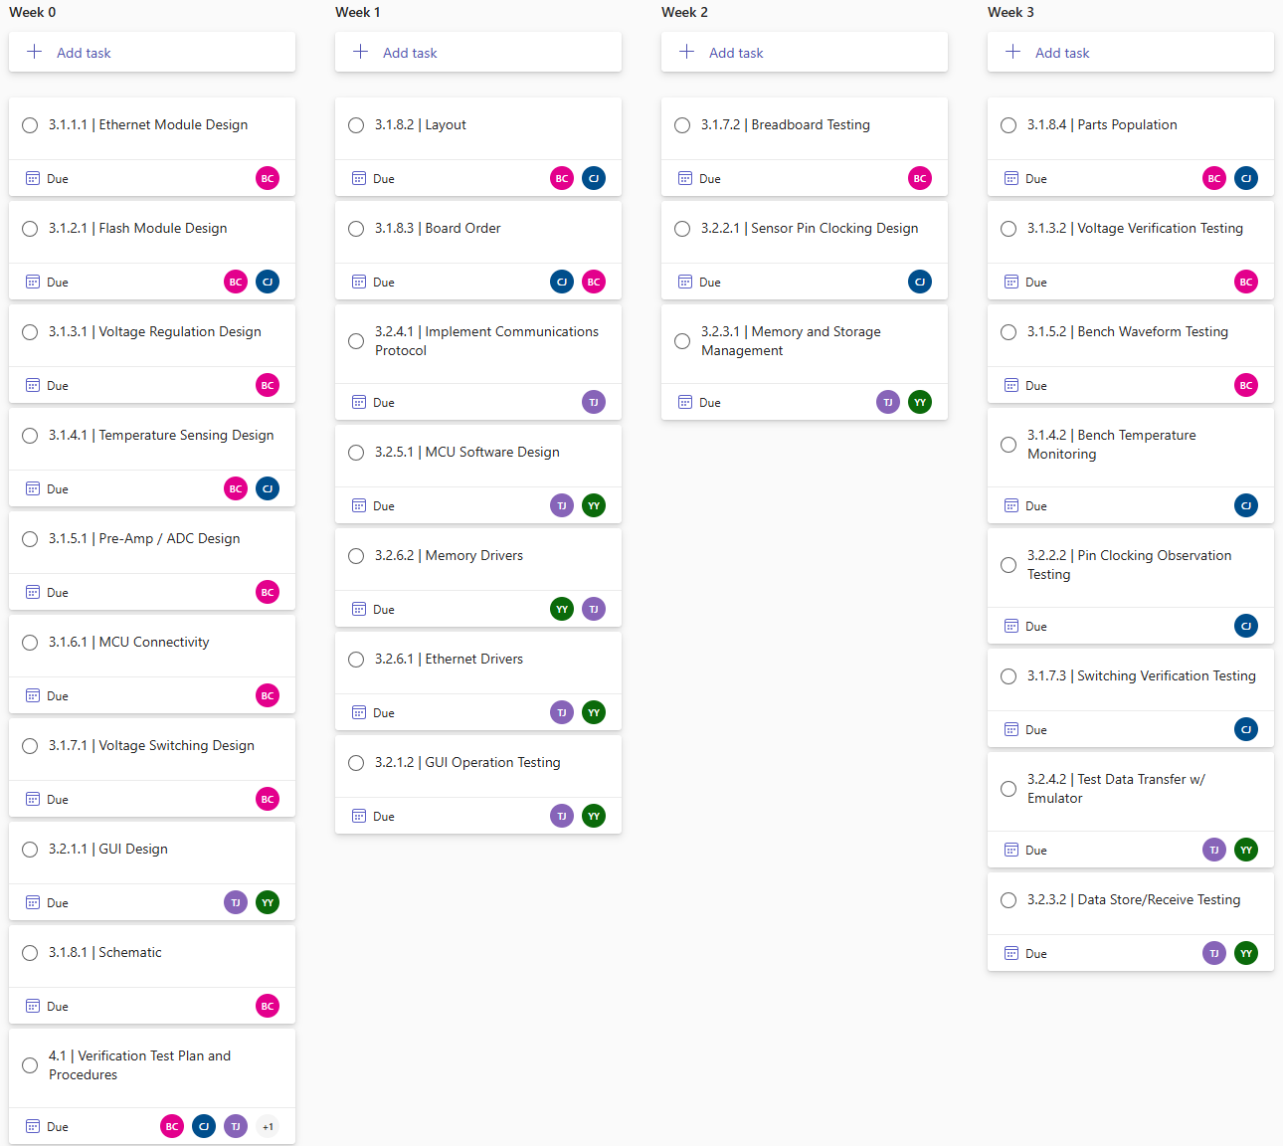
[picture p45: figure]

Sprint Board cont.

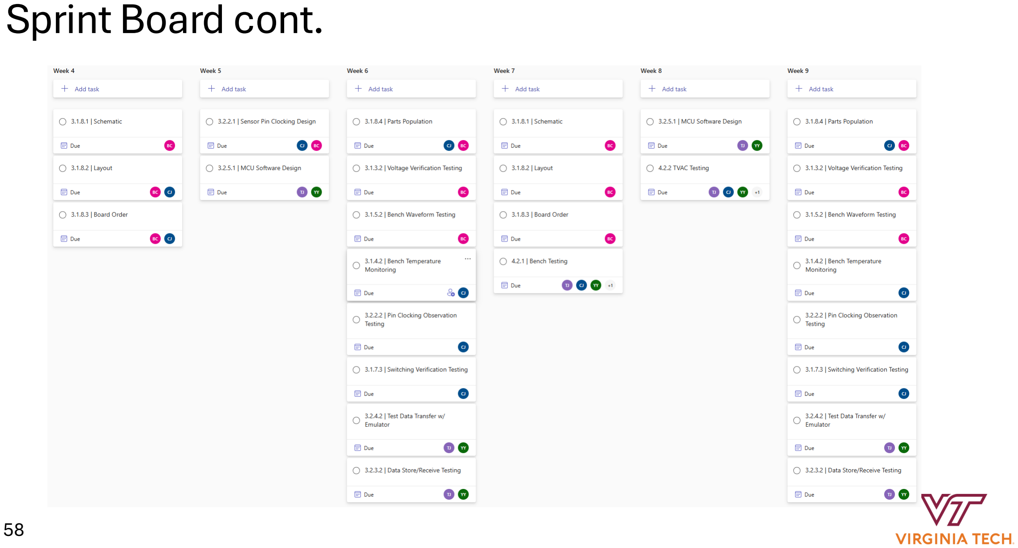
[picture p46: page 58]

Sprint Board cont.

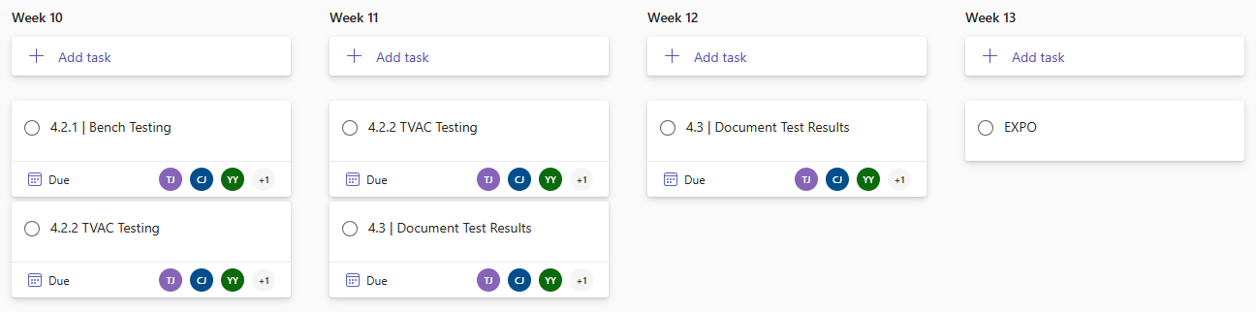
[picture p47: figure]

# Risk Identification/Mitigation

Risk No | Related Risk | RISK | Severity | Probability | Mitigations
1 | 2 | Damage the CCD sensor | High | Low | - Handle the CCD sensor in a cleanroom environment - Use ESD protection - Follow manufacturer handling guidelines.
2 | 1 | Damage circuit components while testing in T-VAC | Medium | Low | - Perform pre-test functional checks - Use appropriate thermal cycling procedures - Monitor temperature and pressure conditions closely
3 | 1,2 | Electrical damage due to incorrect power supply connections | High | Low | - Implement overvoltage and overcurrent protection - Verify connections before powering up-- Use proper grounding techniques.
4 | 1, 2, 3 | Shipping delays | Medium | Medium | - Finalize designs early and order as soon as we’re confident. Our first prototype is most likely going to work exactly how we want it to, so we must redesign quickly to be able to order more parts/PCBs early.
5 | N/A | Our circuit uses too much power | Low | Medium | - Ensure more careful design choices and planning so that the circuit consumes less than 5W
6 | 4, 5 | Revisions to the first prototype or PCB design | Medium | Medium | - Make various prototype designs to compensate for other designs not working

# Risk Matrix Mitigation

| Insignificant 1 | Minor 2 | Significant 3 | Major 4 | Severe 5

5 Almost Certain

4 Likely

3 Moderate | | Too Much Power (Risk 5) | Shipping, Revision (Risk 4, 6)
2 Unlikely | | | Damage in TVAC (Risk 2)
1 Rare | | | | Electrical Damage (Risk 3) | Damage to CCD (Risk 1)

Impact

Probability

# Demo

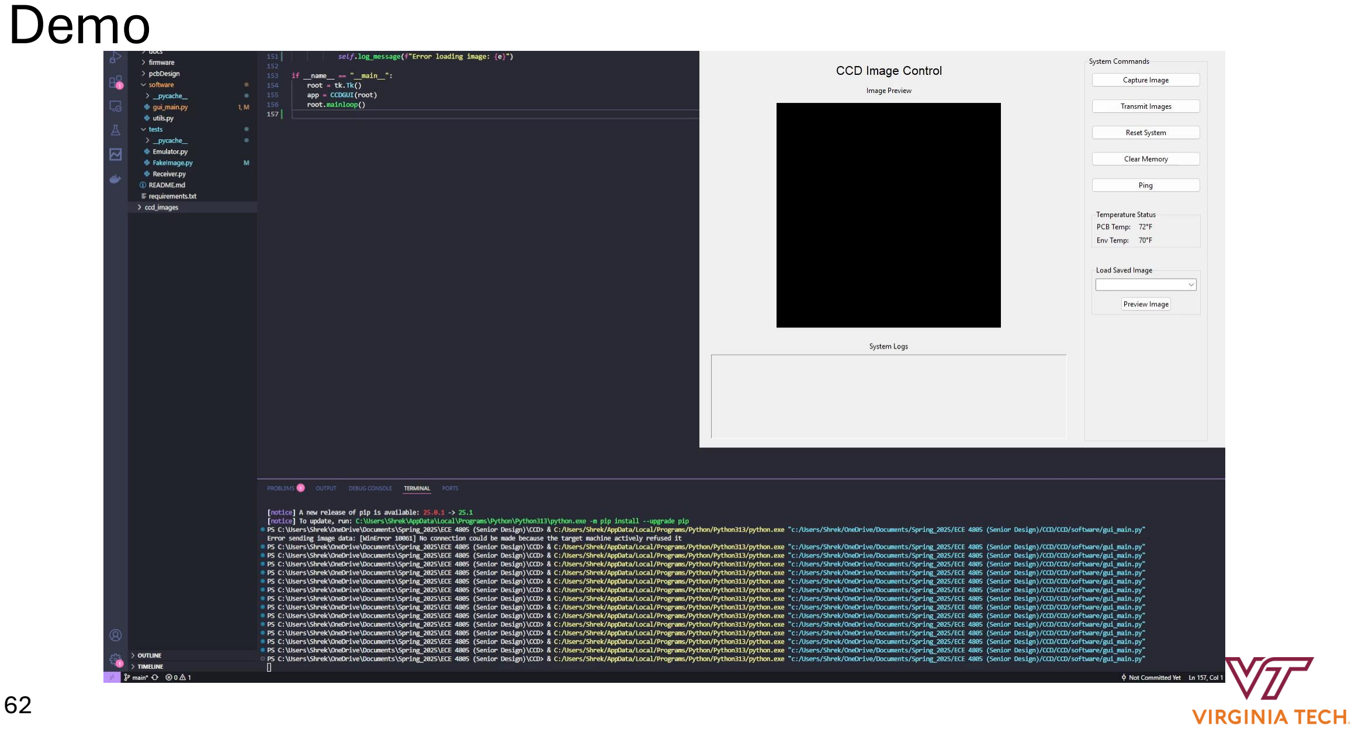
[picture p48: page 62]

# Blank Actions

Task Name | Status | Assigned To | Date
Concept of Operations: “reset array” needs to specify resetting RAM array, not Flash array | Incomplete | Javier, Yifu | 5/1/2025
Concept of Operations: there needs to be a decision tree for “if entire row is shifted” | Incomplete | Javier, Yifu | 5/1/2025
Concept of Operations: because we have no shutter, add a CCD reset step before each new cycle | Incomplete | Javier, Yifu | 5/1/2025
Voltage Regulation: inject noise in simulations to better model an actual circuit | Incomplete | Cody | 5/1/2025
Boost Converter: remove this entirely, it isn’t needed | Incomplete | Cody | 5/1/2025

# Blank Actions

Task Name | Status | Assigned To | Date
MOSFET Switching: try to minimize the voltage peak from the inverter output | Incomplete | Cody | 5/1/2025
CCD Sensor Clocking: review the summing well of the CCD and see if it also needs clocking | Incomplete | Jae | 5/1/2025
Ethernet Module: breadboard the ethernet section before we put it on a PCB | Incomplete | Cody | 5/1/2025
Thermal Sensing: select a target accuracy for the sensors | Incomplete | Jae | 5/1/2025

# Blank Actions

Task Name | Status | Assigned To | Date
Cost Table: review the PCB cost and update according to the temperature rated material we’re going to use | Incomplete | Cody | 5/1/2025
GUI Functionality: explain more clearly what “reset system” is actually resetting (RAM, Flash, etc.) | Incomplete | Javier | 5/1/2025
GUI Functionality: add a “reset CCD sensor” button for resetting the CCD before every operation | Incomplete | Javier | 5/1/2025
Image Data Packet Format: checksum should come after “image data” | Incomplete | Javier, Yifu | 5/1/2025

# Blank Actions

Task Name | Status | Assigned To | Date
Software Subsystem Sequencing: need to define what happens when the system receives a warning or an error, then reflect that in the diagram | Incomplete | Javier, Yifu | 5/1/2025
Software Subsystem Sequencing: ConOps also needs to reflect errors and aborts | Incomplete | Yifu | 5/1/2025
Software Subsystem Sequencing: define what constitutes an error or a warning | Incomplete | Javier | 5/1/2025

# Blank Actions

Task Name | Status | Assigned To | Date
Software Subsystem Sequencing: this can be incorporated in the original diagram, but consider making a Soft Subsystem Sequencing diagram that defines anomaly situations (aborts, etc.) | Incomplete | Javier, Yifu | 5/1/2025
Class Diagram: update based projected changes on warnings and aborts, ConOps, and Image Data Packet Format | Incomplete | Yifu | 5/1/2025
Temperature Sensing: consider RTD or PTRs for temperature sensing | Incomplete | Cody, Jae | 5/1/2025

# Blank Actions

Task Name | Status | Assigned To | Date
Noise Level Testing: check our current method to make sure we know how we’re going to get the electron read noise from this test | Incomplete | Team | 5/1/2025
CCD Image Testing: instead of using the CCD sensor immediately for image testing, consider injecting analog inputs through the Pre-Amp to simulate a CCD input | Incomplete | Cody, Jae | 5/1/2025
TVAC Testing: make sure we have a harness for our PCB for when we use the TVAC chamber | Incomplete | Team | 5/1/2025

# Blank Actions

Task Name | Status | Assigned To | Date
Sprint Board: breadboarding should come before board order | Incomplete | Cody, Jae | 5/1/2025
Sprint Board: possibly move board order back a week or two to ensure time for breadboard testing | Incomplete | Cody, Jae | 5/1/2025
Sprint Board: add soldering to our schedule | Incomplete | Cody, Jae | 5/1/2025
System Testing: add how each system test is checking for some requirement. Use specific actions from the WBS and link them with certain tests | Incomplete | Team | 5/1/2025

# Thank You!
