Rheinjaeger/CCD/Design_Files/12-5-2025_PCBschematic.pdf

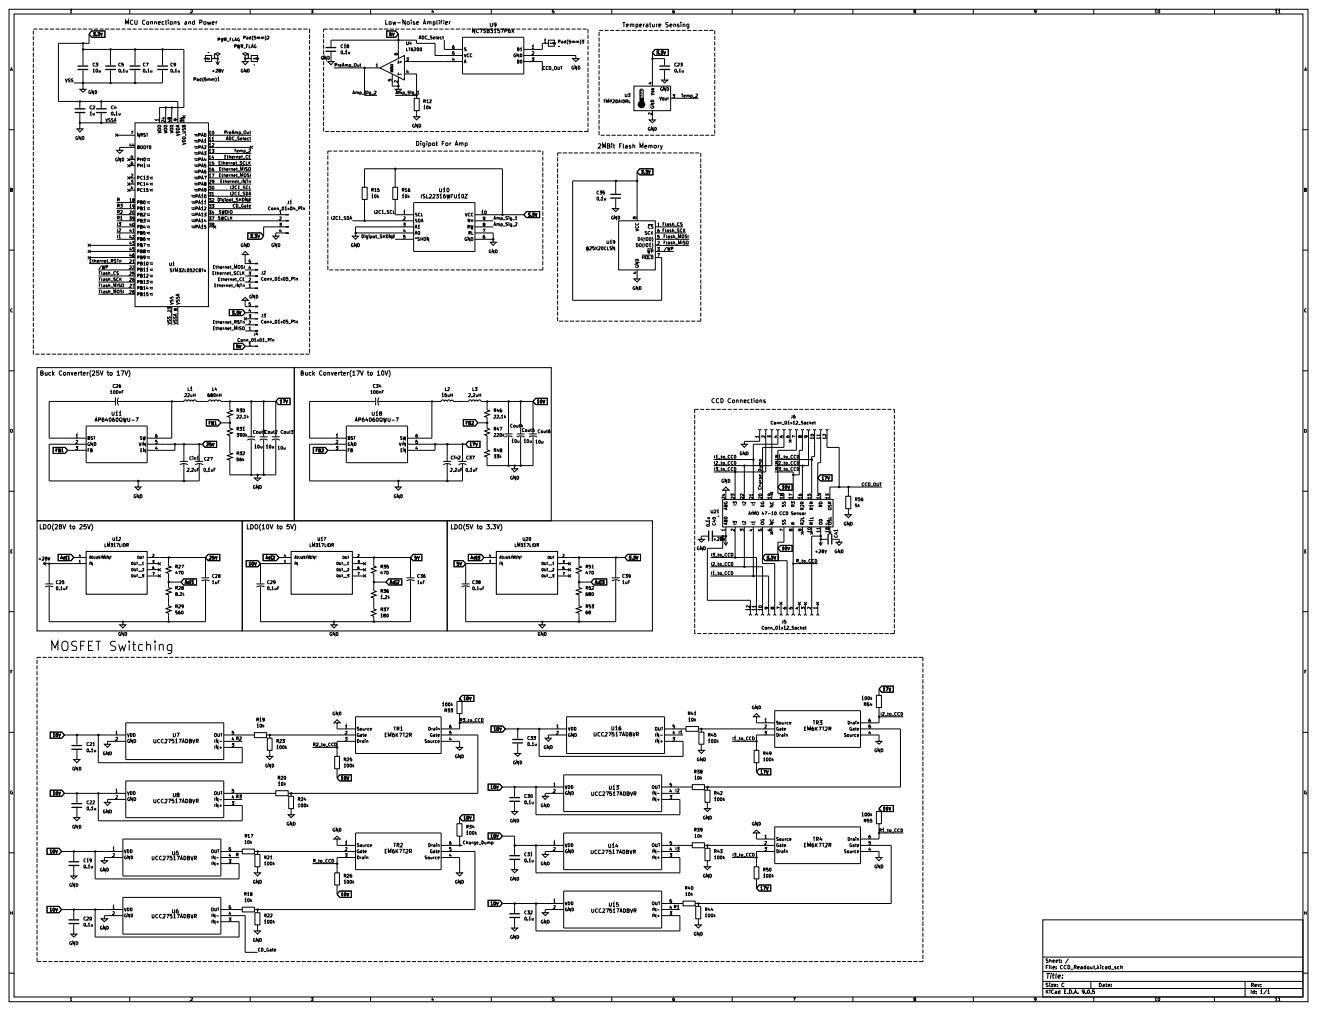
[picture p97: page 1]
