Rheinjaeger/CCD/pcbDesign/schematic_mde.pdf

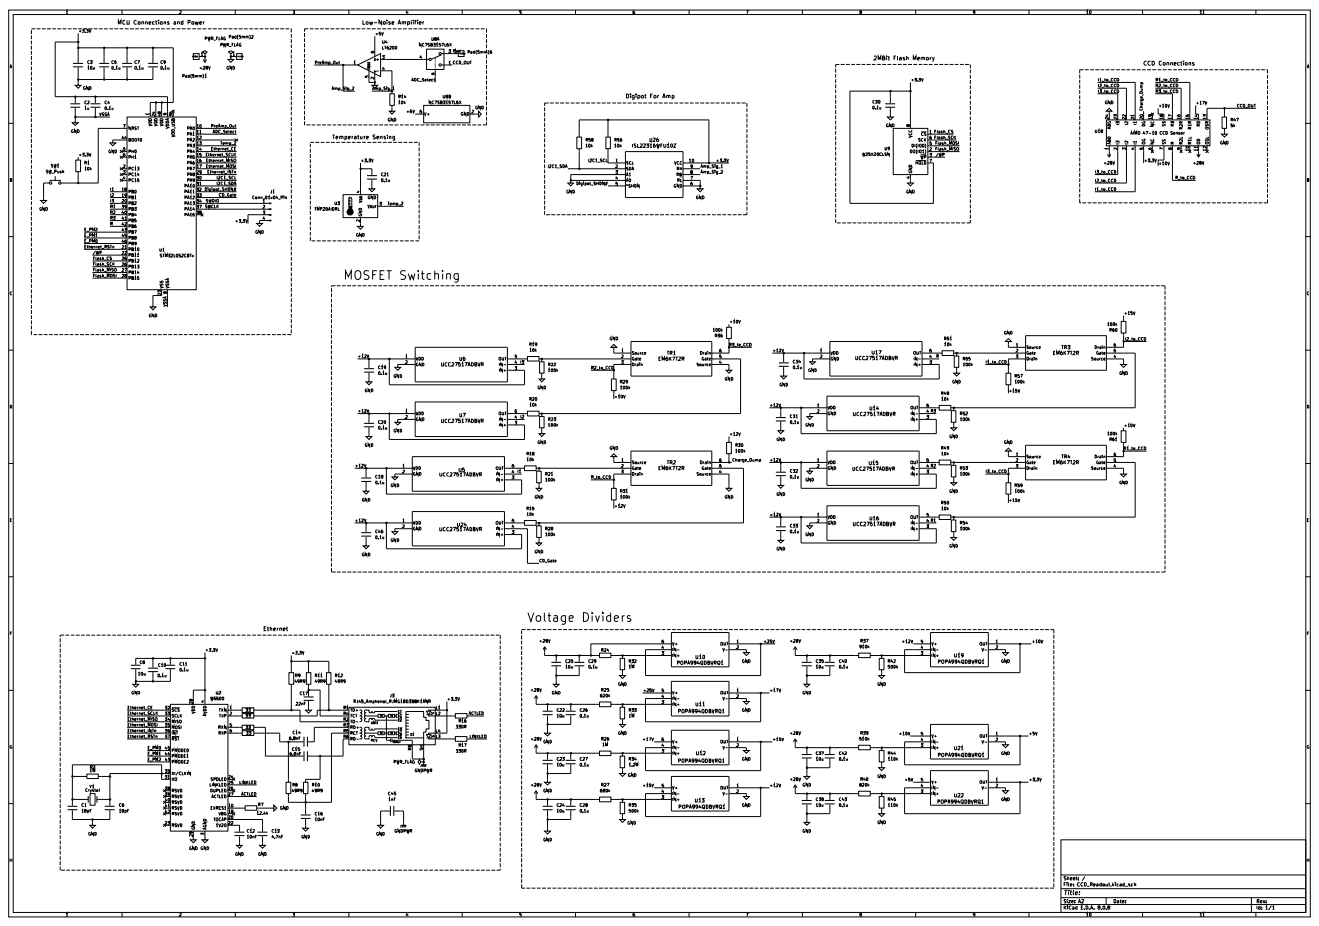
[picture p98: page 1]
