Rheinjaeger/CCD/pcbDesign/CCD Readout/CCD_Readout.kicad_pcb

## KiCad design pcbDesign/CCD Readout/CCD_Readout.kicad_pcb (2025-10-07)

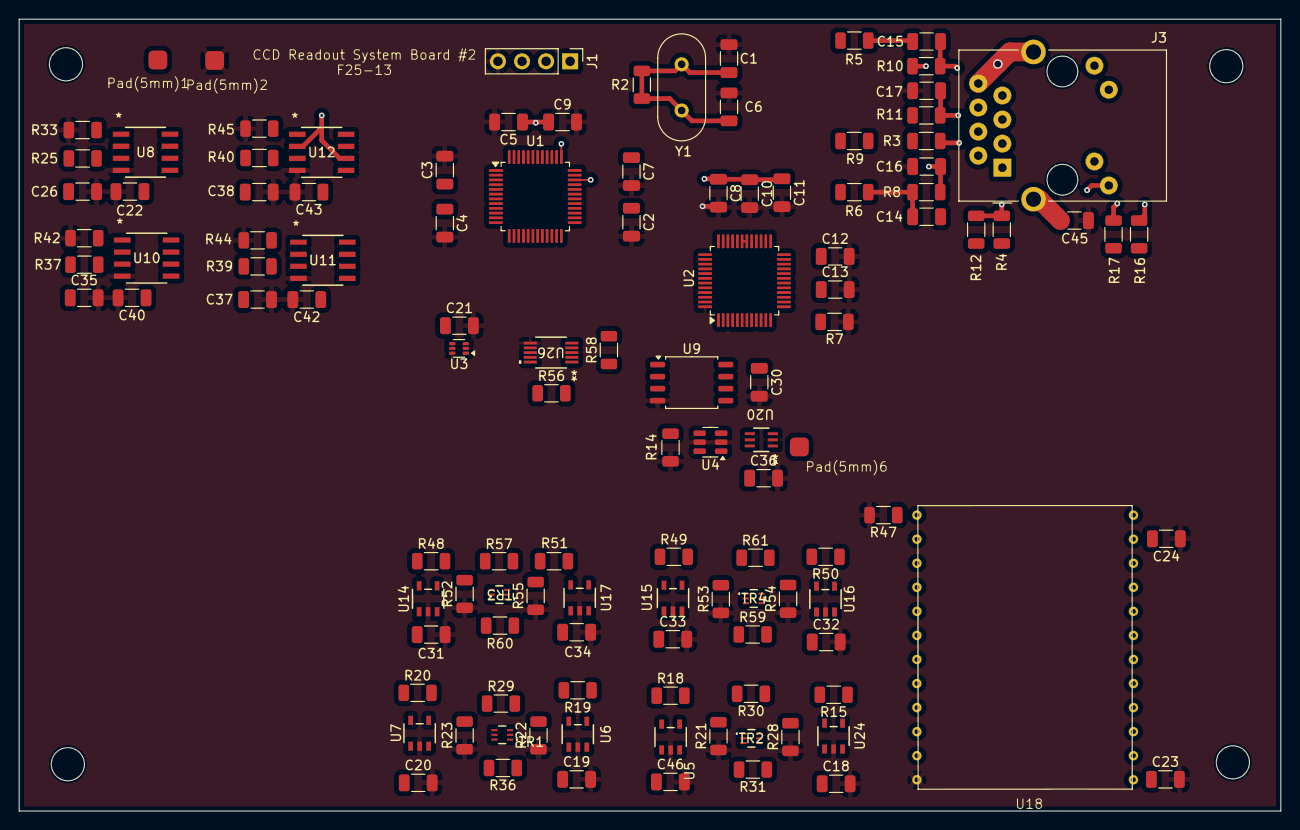
[picture p99: board CCD_Readout.kicad_pcb from above]

Board: 6 copper layers, 133.2 x 83.6 mm, 118 parts (0 on the bottom side), 91 nets.

Parts:
C1, C6: 18pF; C_1206_3216Metric
C2: 1u; C_1206_3216Metric
C3, C8, C22, C35, C37, C38: 10u; C_1206_3216Metric
C4, C5, C7, C9, C10, C11, C18, C19, C20, C21, C23, C24, C26, C30, C31, C32, C33, C34, C36, C40, C42, C43, C46: 0.1u; C_1206_3216Metric
C12, C16: 10nF; C_1206_3216Metric
C13: 4.7nF; C_1206_3216Metric
C14, C15: 6.8nF; C_1206_3216Metric
C17: 22nF; C_1206_3216Metric
C45: 1nF; C_1206_3216Metric
J1: Conn_01x04_Pin; PinHeader_1x04_P2.54mm_Vertical
J3: RJ45_Amphenol_RJMG1BD3B8K1ANR
Pad(5mm)1, Pad(5mm)2, Pad(5mm)6: 2mm Pad
R2: 1M; R_1206_3216Metric
R3, R4, R5, R6: 33; R_1206_3216Metric
R7: 12.4k; R_1206_3216Metric
R8, R9, R10, R11, R12: 49R9; R_1206_3216Metric
R14, R15, R18, R19, R20, R48, R49, R50, R51, R56, R58: 10k; R_1206_3216Metric
R16, R17: 330R; R_1206_3216Metric
R21, R22, R23, R28, R29, R30, R31, R33, R36, R42, R44, R45, R52, R53, R54, R55, R57, R59, R60, R61: 100k; R_1206_3216Metric
R25: 68k; R_1206_3216Metric
R37: 180k; R_1206_3216Metric
R39: 470k; R_1206_3216Metric
R40: 750k; R_1206_3216Metric
R47: 5k; R_1206_3216Metric
TR1, TR2, TR3, TR4: EM6K7T2R; TRANS_EM6_ROM
U1: STM32L052C8Tx; LQFP-48_7x7mm_P0.5mm
U2: W5500; LQFP-48_7x7mm_P0.5mm
U3: TMP20AIDRL; SOT-563
U4: LT6200; TSOT-23-6
U5, U6, U7, U14, U15, U16, U17, U24: UCC27517ADBVR; DBV5_TEX
U8, U10, U11, U12: OPA2994IDR; SOIC8_3P98X5_TEX
U9: W25X20CLSN; SOP-8_5.28x5.23mm_P1.27mm
U18: CCD Sensor
U20: NC7SB3157P6X; SC-70_6L_ONS-M
U26: ISL22316WFU10Z; MSOP10_3X3_INR
Y1: Crystal; Crystal_HC49-U_Vertical

Connections:
+28V: C22.1, C23.1, C24.2, C26.1, C35.1, C37.1, C38.1, C40.1, C42.1, C43.1, Pad(5mm)1.1 (In/Out), R25.1, R37.1, R39.1, R40.1, U8.7 (VCC+), U18.1 (ABD), U18.11 (OD)
/+3.3V: C2.1, C3.1, C4.1, C5.1, C7.1, C8.1, C9.1, C10.1, C11.1, C21.1, C30.1, J1.3, J3.L1, J3.L4, R9.1, R11.1, R12.1, R56.1, R58.2, U1.1 (VDD), U1.9 (VDDA), U1.24 (VDD), U1.48 (VDD), U2.4 (AVDD), U2.8 (AVDD), U2.11 (AVDD), U2.15 (AVDD), U2.17 (AVDD), U2.21 (AVDD), U2.28 (VDD), U3.4 (V_{DD}), U9.7 (~HOLD), U9.8 (VCC), U12.2 (IN-), U12.6 (OUT), U18.5 (OG), U26.10 (VCC)
/+5V: C36.1, U4.6 (V+), U11.2 (IN-), U11.6 (OUT), U12.7 (VCC+), U20.5 (VCC)
/+10V: R29.1, R36.1, R61.1, U10.2 (IN-), U10.6 (OUT), U11.7 (VCC+), U18.7 (SS), U18.18 (SS)
/+12V: C18.1, C19.1, C20.1, C31.1, C32.1, C33.1, C34.1, C46.1, R30.2, R31.1, U5.1 (VDD), U5.3 (IN+), U6.1 (VDD), U6.3 (IN+), U7.1 (VDD), U7.3 (IN+), U14.1 (VDD), U14.3 (IN+), U15.1 (VDD), U15.3 (IN+), U16.1 (VDD), U16.3 (IN+), U17.1 (VDD), U17.3 (IN+), U24.1 (VDD), U24.3 (IN+)
/+15V: R57.1, R59.1, R60.1
/+17V: U8.2 (IN-), U8.6 (OUT), U10.7 (VCC+), U18.14 (RD)
/ACTLED: R16.2, U2.27 (ACTLED)
/ADC_Select: U1.11 (PA1), U20.6 (S)
/Amp_Sig_1: R14.1, U4.4 (-), U26.9 (RH)
/Amp_Sig_2: U1.10 (PA0), U4.1, U26.8 (RW)
/CCD_OUT: R47.1, U18.13 (OSR), U20.3 (B0)
/CD_Gate: U1.33 (PA12), U24.4 (IN-)
/Charge_Dump: R30.1, TR2.6 (Drain), U18.20 (DG)
/Digipot_SHDN#: U1.32 (PA11), U26.5 (*SHDN)
/E_PM0: U1.46 (PB9), U2.45 (PMODE0)
/E_PM1: U1.45 (PB8), U2.44 (PMODE1)
/E_PM2: U1.43 (PB7), U2.43 (PMODE2)
/Ethernet_CE: U1.14 (PA4), U2.32 (~SCS)
/Ethernet_INTn: U1.29 (PA8), U2.36 (~INT)
/Ethernet_MISO: U1.16 (PA6), U2.34 (MISO)
/Ethernet_MOSI: U1.17 (PA7), U2.35 (MOSI)
/Ethernet_RSTn: U1.21 (PB10), U2.37 (~RST)
/Ethernet_SCLK: U1.15 (PA5), U2.33 (SCLK)
/Flash_CS: U1.25 (PB12), U9.1 (~CS)
/Flash_MISO: U1.27 (PB14), U9.2 (DO(IO1))
/Flash_MOSI: U1.28 (PB15), U9.5 (DI(IO0))
/Flash_SCK: U1.26 (PB13), U9.6 (SCK)
/I1: U1.18 (PB0), U5.4 (IN-)
/I1_to_CCD: R57.2, TR3.3 (Drain), U18.4 (I1), U18.21 (I1)
/I2: U1.19 (PB1), U7.4 (IN-)
/I2C1_SCL: R56.2, U1.30 (PA9), U26.1 (SCL)
/I2C1_SDA: R58.1, U1.31 (PA10), U26.2 (SDA)
/I2_to_CCD: R60.2, TR3.6 (Drain), U18.3 (I2), U18.22 (I2)
/I3: U1.20 (PB2), U6.4 (IN-)
/I3_to_CCD: R59.2, TR4.3 (Drain), U18.2 (I3), U18.23 (I3)
/LINKLED: R17.2, U2.25 (LINKLED)
/R: U1.42 (PB6), U17.4 (IN-)
/R1: U1.39 (PB3), U16.4 (IN-)
/R1_to_CCD: R61.2, TR4.6 (Drain), U18.15 (R1R)
/R2: U1.40 (PB4), U15.4 (IN-)
/R2_to_CCD: R29.2, TR1.3 (Drain), U18.16 (R2R)
/R3: U1.41 (PB5), U14.4 (IN-)
/R3_to_CCD: R36.2, TR1.6 (Drain), U18.17 (R3)
/R_to_CCD: R31.2, TR2.3 (Drain), U18.8 (R)
/SWCLK: J1.2, U1.37 (PA14)
/SWDIO: J1.1, U1.34 (PA13)
/Temp_2: U1.13 (PA3), U3.3 (V_{OUT})
//WP: U1.22 (PB11), U9.3 (~WP)
GND: C1.2, C2.2, C3.2, C4.2, C5.2, C6.2, C7.2, C8.2, C9.2, C10.2, C11.2, C12.2, C13.2, C16.2, C17.2, C18.2, C19.2, C20.2, C21.2, C22.2, C23.2, C24.1, C26.2, C30.2, C31.2, C32.2, C33.2, C34.2, C35.2, C36.2, C37.2, C38.2, C40.2, C42.2, C43.2, C45.1, C46.2, J1.4, Pad(5mm)2.1 (In/Out), R7.1, R14.2, R21.1, R22.1, R23.1, R28.1, R33.1, R42.1, R44.1, R45.1, R47.2, R52.1, R53.1, R54.1, R55.1, TR1.1 (Source), TR1.4 (Source), TR2.1 (Source), TR2.4 (Source), TR3.1 (Source), TR3.4 (Source), TR4.1 (Source), TR4.4 (Source), U1.8 (VSSA), U1.23 (VSS), U1.35 (VSS), U1.44 (BOOT0), U1.47 (VSS), U2.3 (AGND), U2.9 (AGND), U2.14 (AGND), U2.16 (AGND), U2.19 (AGND), U2.29 (GND), U2.48 (AGND), U3.2 (GND), U3.6 (GND), U4.2 (V-), U4.5 (~ENABLE), U5.2 (GND), U6.2 (GND), U7.2 (GND), U8.4 (VCC-), U9.4 (GND), U10.4 (VCC-), U11.4 (VCC-), U12.4 (VCC-), U14.2 (GND), U15.2 (GND), U16.2 (GND), U17.2 (GND), U18.24 (ABG), U20.2 (GND), U24.2 (GND), U26.3 (A1), U26.4 (A0), U26.6 (GND), U26.7 (RL)
GNDPWR: C45.2, J3.R8, J3.SH
unnamed: C14.1, R6.2, R8.1
unnamed: C15.1, R5.2
unnamed: J3.L2, R16.1
unnamed: J3.L3, R17.1
unnamed: C16.1, J3.R5 (RCT), R8.2, R10.2
unnamed: C14.2, J3.R3 (RD+)
unnamed: C15.2, J3.R6 (RD-), R10.1
unnamed: C17.1, J3.R4 (TCT), R11.2
unnamed: J3.R1 (TD+), R4.2, R12.2
unnamed: J3.R2 (TD-), R3.2, R9.2
unnamed: Pad(5mm)6.1 (In/Out), U20.1 (B1)
unnamed: R15.2, R28.2, TR2.5 (Gate)
unnamed: R18.2, R21.2, TR2.2 (Gate)
unnamed: R19.2, R22.2, TR1.2 (Gate)
unnamed: R20.2, R23.2, TR1.5 (Gate)
unnamed: R48.2, R52.2, TR3.5 (Gate)
unnamed: R49.2, R53.2, TR4.2 (Gate)
unnamed: R50.2, R54.2, TR4.5 (Gate)
unnamed: R51.2, R55.2, TR3.2 (Gate)
unnamed: C12.1, U2.22 (1V2O)
unnamed: R7.2, U2.10 (EXRES1)
unnamed: R5.1, U2.5 (RXN)
unnamed: R6.1, U2.6 (RXP)
unnamed: C13.1, U2.20 (TOCAP)
unnamed: R3.1, U2.1 (TXN)
unnamed: R4.1, U2.2 (TXP)
unnamed: C1.1, C6.1, R2.1, R2.2, U2.30 (XI/CLKIN), U2.31 (XO), Y1.1, Y1.2
unnamed: R18.1, U5.5 (OUT)
unnamed: R19.1, U6.5 (OUT)
unnamed: R20.1, U7.5 (OUT)
unnamed: R25.2, R33.2, U8.3 (IN+)
unnamed: R37.2, R42.2, U10.3 (IN+)
unnamed: R39.2, R44.2, U11.3 (IN+)
unnamed: R40.2, R45.2, U12.3 (IN+)
unnamed: R48.1, U14.5 (OUT)
unnamed: R49.1, U15.5 (OUT)
unnamed: R50.1, U16.5 (OUT)
unnamed: R51.1, U17.5 (OUT)
unnamed: U4.3 (+), U20.4 (A)
unnamed: R15.1, U24.5 (OUT)
