Rheinjaeger/CCD/firmware/CCD_Subsystem/Core/Src/main.c

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
/* Includes */
#include "main.h"
#include "net_if.h"
/* Private includes */
/* Private typedef */
/* Private define */
/* Private macro */
/* Private variables */
ADC_HandleTypeDef hadc;

I2C_HandleTypeDef hi2c1;

IWDG_HandleTypeDef hiwdg;

LPTIM_HandleTypeDef hlptim1;

SPI_HandleTypeDef hspi2;

void SystemClock_Config(void);
static void MX_GPIO_Init(void);
static void MX_IWDG_Init(void);
static void MX_SPI2_Init(void);
static void MX_ADC_Init(void);
static void MX_I2C1_Init(void);
static void MX_LPTIM1_Init(void);
/**
  * @brief  The application entry point.
  *
  */

int main(void)
{
  /* HAL & clocks */
  HAL_Init();
  SystemClock_Config();

  /* GPIO init */
  MX_GPIO_Init();
  MX_SPI2_Init();

  /* GPIO Reset of CCD_R_PIN */
  HAL_GPIO_WritePin(GPIOB, CCD_R_Pin, GPIO_PIN_RESET);

  NET_Init();

  while (1)
  {
    HAL_GPIO_TogglePin(GPIOB, CCD_R_Pin);
    HAL_Delay(1000);
  }
}

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
/* USER CODE BEGIN 4 */
void ad_dataflush(void)
{


}
/*
*********************************************************************************************************
*   Function Name: bsp_RunPer1ms
*   Description  : This function is called once every 1 ms by the Systick interrupt.
*                  See the timer interrupt service routine in bsp_timer.c.
*                  Some periodic tasks can be placed here, for example: touch coordinate scanning.
*   Parameter    : None
*   Return Value : None
*********************************************************************************************************
*/

void bsp_RunPer1ms(void)
{


}

/*
*********************************************************************************************************
*   Function Name: bsp_RunPer10ms
*   Description  : This function is called once every 10 ms by the Systick interrupt.
*                  See the timer interrupt service routine in bsp_timer.c.
*                  Tasks with less strict timing requirements can be placed here,
*                  for example: key scanning, buzzer control, etc.
*   Parameter    : None
*   Return Value : None
*********************************************************************************************************
*/

void bsp_RunPer10ms(void)
{
	static uint8_t count;

	count++;
	if(count>=50)
	{
		count=0;

	}
}
/* USER CODE END 4 */
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
