Rheinjaeger/CCD/firmware/CCD_Subsystem/Core/Inc/main.h

#define PreAmp_Out_Pin GPIO_PIN_0
#define PreAmp_Out_GPIO_Port GPIOA
#define ADC_Select_Pin GPIO_PIN_1
#define ADC_Select_GPIO_Port GPIOA
#define Temp_2_Pin GPIO_PIN_3
#define Temp_2_GPIO_Port GPIOA
#define Ethernet_CE_Pin GPIO_PIN_4
#define Ethernet_CE_GPIO_Port GPIOA
#define Ethernet_SCK_Pin GPIO_PIN_5
#define Ethernet_SCK_GPIO_Port GPIOA
#define Ethernet_MISO_Pin GPIO_PIN_6
#define Ethernet_MISO_GPIO_Port GPIOA
#define Ethernet_MOSI_Pin GPIO_PIN_7
#define Ethernet_MOSI_GPIO_Port GPIOA
#define CCD_I1_Pin GPIO_PIN_0
#define CCD_I1_GPIO_Port GPIOB
#define CCD_I2_Pin GPIO_PIN_1
#define CCD_I2_GPIO_Port GPIOB
#define CCD_I3_Pin GPIO_PIN_2
#define CCD_I3_GPIO_Port GPIOB
#define Ethernet_RST_Pin GPIO_PIN_10
#define Ethernet_RST_GPIO_Port GPIOB
#define FLASH_WP_Pin GPIO_PIN_11
#define FLASH_WP_GPIO_Port GPIOB
#define FLASH_CS_Pin GPIO_PIN_12
#define FLASH_CS_GPIO_Port GPIOB
#define FLASH_SCK_Pin GPIO_PIN_13
#define FLASH_SCK_GPIO_Port GPIOB
#define FLASH_MISO_Pin GPIO_PIN_14
#define FLASH_MISO_GPIO_Port GPIOB
#define FLASH_MOSI_Pin GPIO_PIN_15
#define FLASH_MOSI_GPIO_Port GPIOB
#define Ethernet_INT_Pin GPIO_PIN_8
#define Ethernet_INT_GPIO_Port GPIOA
#define Digipot_SHDN__Pin GPIO_PIN_11
#define Digipot_SHDN__GPIO_Port GPIOA
#define CD_Gate_Pin GPIO_PIN_12
#define CD_Gate_GPIO_Port GPIOA
#define CCD_R1_Pin GPIO_PIN_3
#define CCD_R1_GPIO_Port GPIOB
#define CCD_R2_Pin GPIO_PIN_4
#define CCD_R2_GPIO_Port GPIOB
#define CCD_R3_Pin GPIO_PIN_5
#define CCD_R3_GPIO_Port GPIOB
#define CCD_R_Pin GPIO_PIN_6
#define CCD_R_GPIO_Port GPIOB
