Rheinjaeger/CCD/(commit log)

2025-09-25 Added CCD_Module, Temperature, Data_Integrity, Command_Handler, and W5500 module
2025-10-07 Finished fixing errors with System controller, command handler and main
    [command_handler.h, main.c, system_controller.c, system_controller.h]
2025-10-08 Added the network corrections
    [main.c]
2025-11-04 Added W5500 Drivers, Stable GPIO 1.0 test build with SPI memory modules
2025-11-17 Added ethernet files and I2C setup
